bell-ha/fog-cue/1_아이디어발표/parts/buzzer_active.png

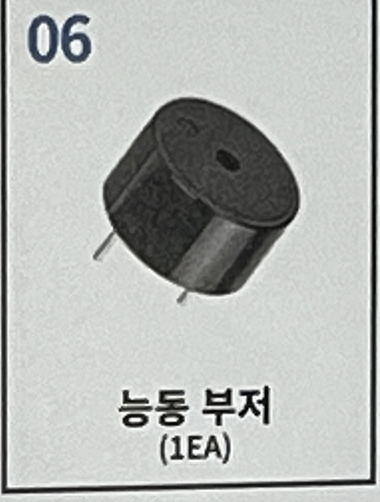
1_아이디어발표/parts/buzzer_active.png
