bell-ha/fog-cue/_발표자료_보관/parts/pulse.png

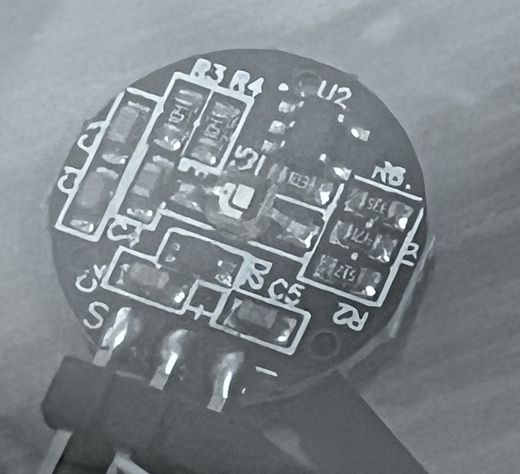
_발표자료_보관/parts/pulse.png
