bell-ha/fog-cue/2_중간발표/32203482이종하_개인맞춤형디바이스개발_중간발표.pptx

## 보행동결 자극 시스템

중간발표

IMU 기반 보행 동결 검출 및 청각 자극 시스템

32203482 이종하

## 목차

중간발표

01

프로젝트 개요

시스템 구성

05

동결 판정

설계 변경 사항

02

06

데이터 수집

03

향후 계획

07

보행 신호 분석

04

## 프로젝트 개요

문제 파킨슨 환자는 걷다가 갑자기 발이 바닥에 붙는 현상이 일어난다 (보행 동결)

걸음 측정

허리에 찬 가속도 센서

1

동결 감지

발이 안 떨어지는 순간

2

메트로놈 재생

직전 걸음 빠르기에 맞춤

3

고려할 점

계속 울리면 귀가 익숙해져 반응이 줄어듦, 그래서 동결일 때만 울림

다시 걸으면 소리 멈춤

## 시스템 구성(회로 연결)

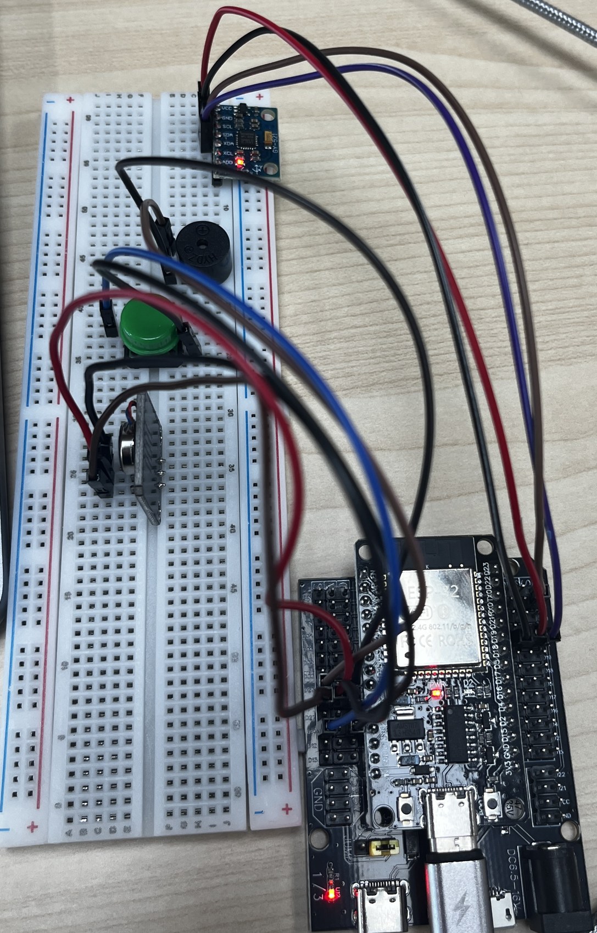
[picture p3: figure]
브레드보드와 ESP32 확장보드 실물
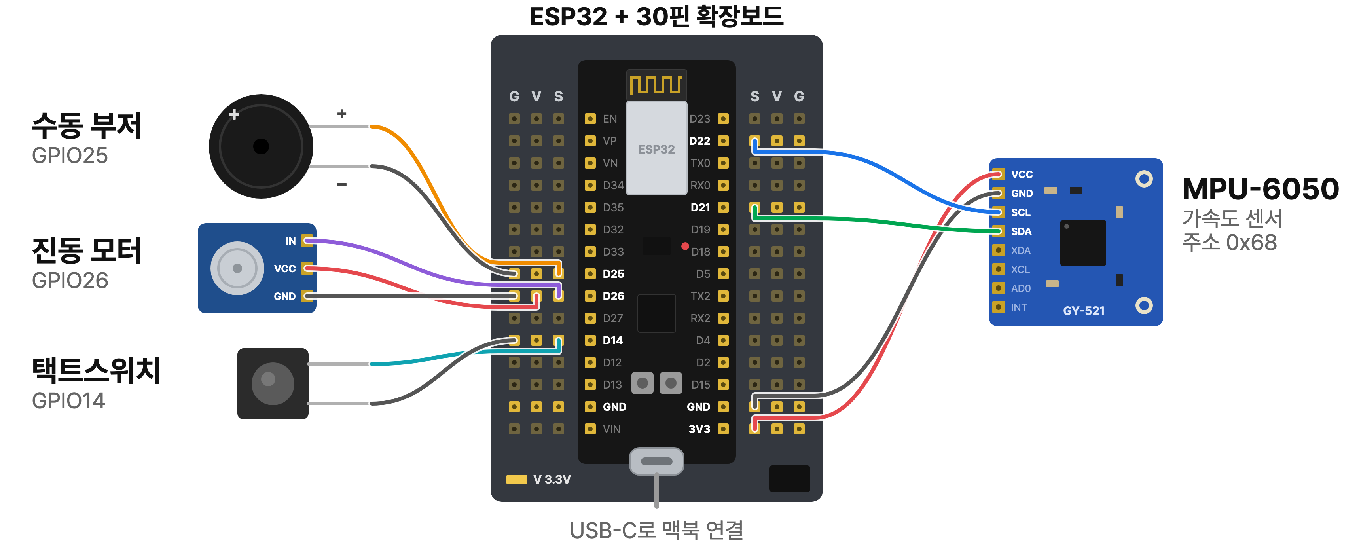
[picture p4: figure]
ESP32 확장보드와 MPU-6050, 수동 부저, 진동 모터, 택트스위치 연결도

## 시스템 구성(기능 테스트)

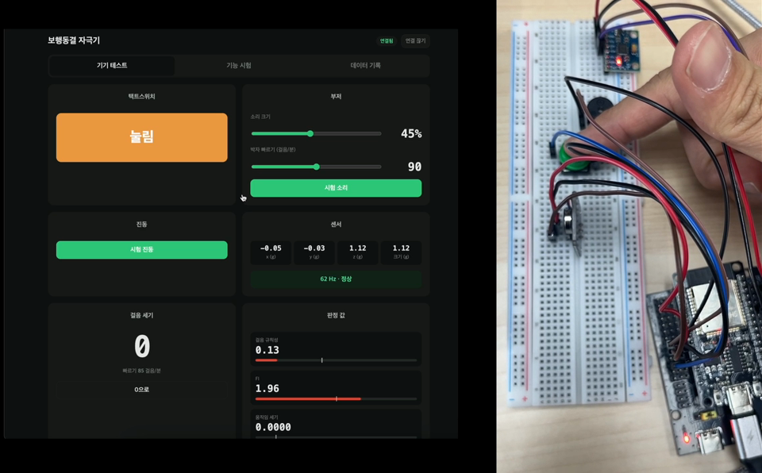
[picture p5: figure]
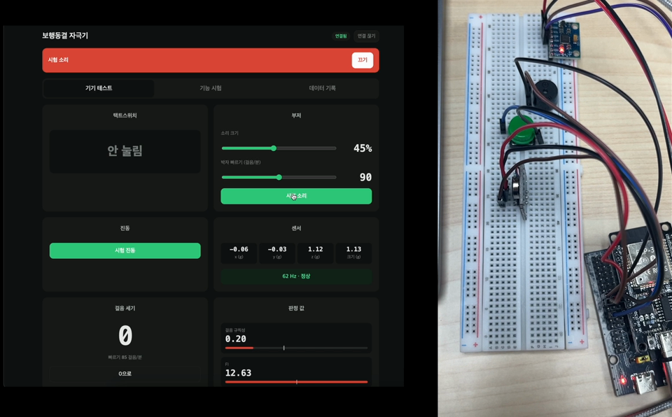
[picture p6: figure]

버튼

진동

부저

걸음

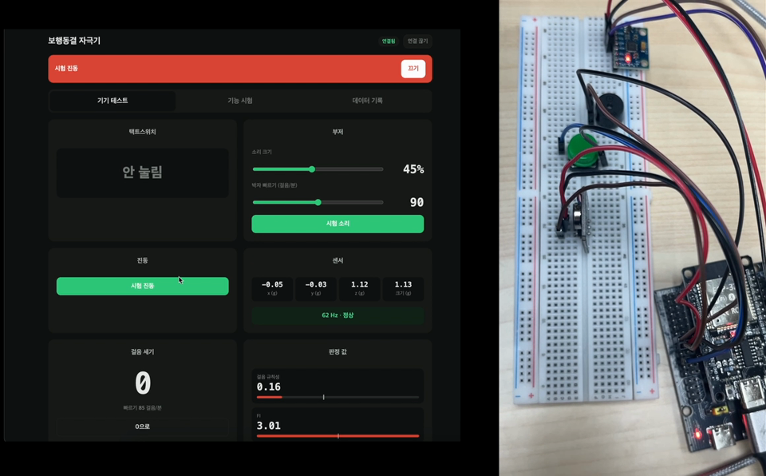
[picture p7: figure]
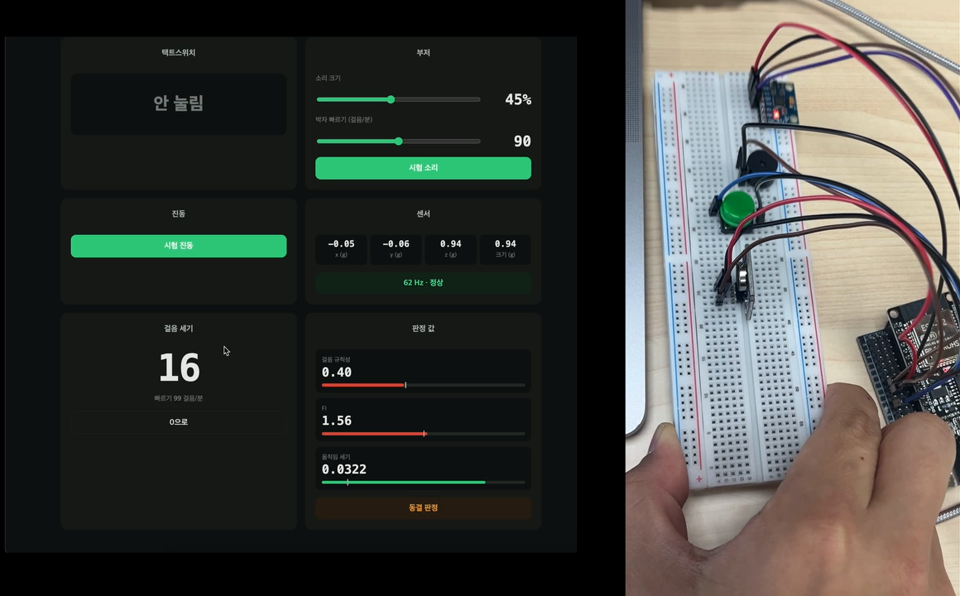
[picture p8: figure]

## 시스템 구성(착용과 기록 환경 가정)

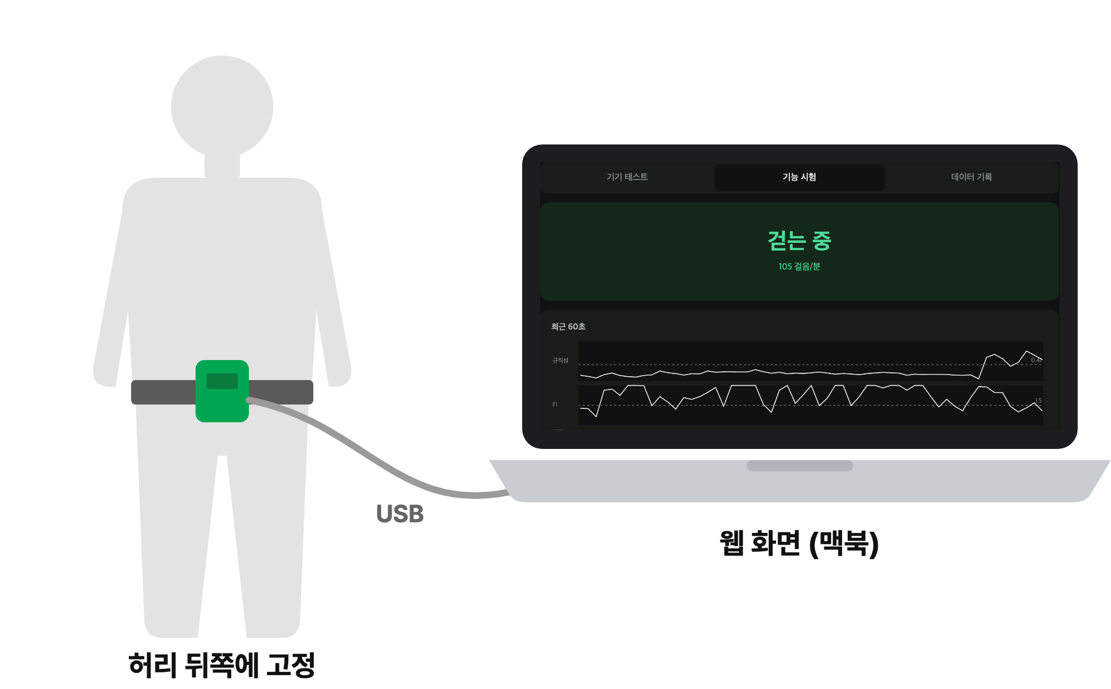
[picture p9: figure]
허리 뒤쪽에 고정한 기기와 USB로 연결한 맥북 기록 화면

62.0~62.4 Hz

샘플레이트 (설계값 62.5 Hz)

32 / 32

걸음 세기

Notes: 센서 값을 1초에 62번 읽음.(DAPHNet 파킨슨 환자 데이터의 측정 속도)

32걸음 걸었을 때 32걸음을 세었다.(환자 데이터도 그렇게 구성)

## 데이터 수집

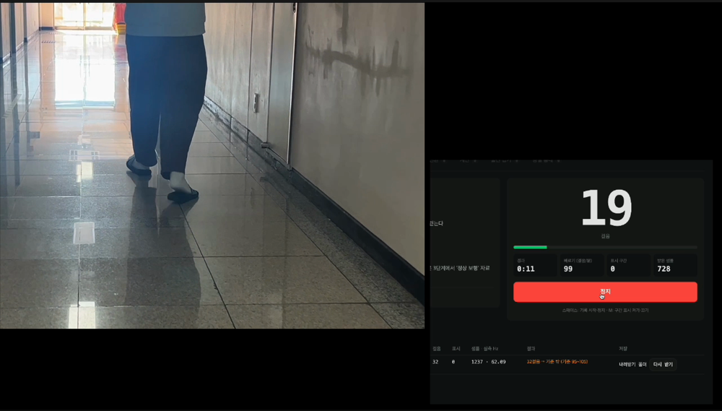
[picture p10: figure]

걷기

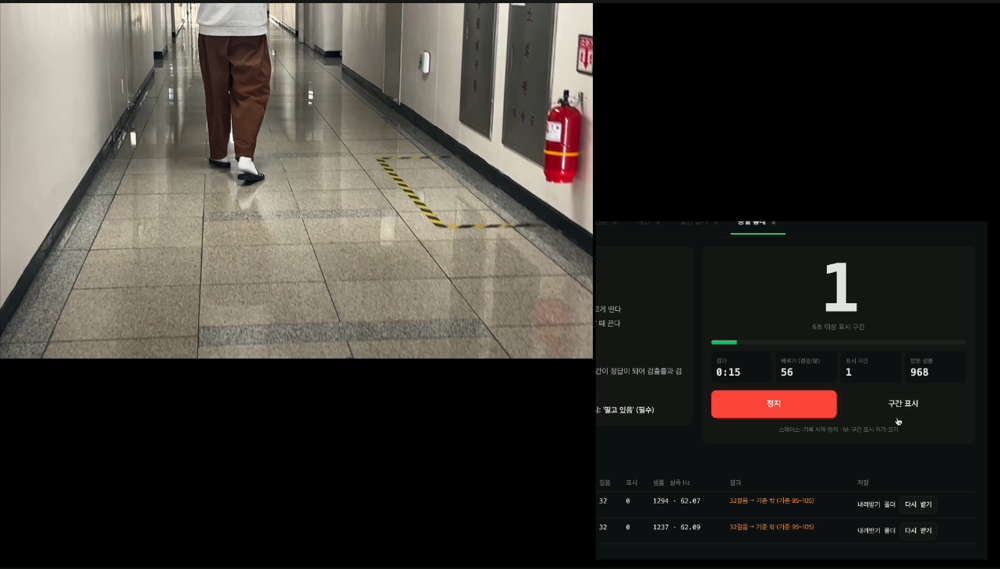
[picture p11: figure]

동결 재현

## 보행 신호 분석

흔들림 크기: 걷기 0.14~0.21 g, 동결 재현 0.08~0.24 g

흔들림 크기 (g)

걷기

걸음 규칙성: 걷기 0.43~0.68, 동결 재현 0.09~0.37

걸음 규칙성
4초동안 같은 모양의 걸음이 반복되는 정도 (0~1)

0.14~0.21

동결 재현

0.08~0.24

0

0.1

0.2

0.3

걸음 규칙성 (0~1)

걷기

기준 0.41

3~8 Hz 떨림(FI)

0.43~0.68

동결 재현

서 있는 동안에도 걸음이 세어짐

0.09~0.37

0

0.5

1

Notes: g(가속도 단위): 중력을 1g라 보고, 흔들림 0.14g는 중력의 14%정도 흔들렸다.
Hz: 1초에 몇 번 흔들렸는지
걸음 규칙성: 4초 안에서 같은 모양의 흔들림이 되풀이 되는 정도. 1에 가까울 수록 고르게 걷는 거
FI(Freeze Index,동결지수): 떨림의 세기(3~8Hz)를 걸음 리듬의 세기로 나눈 비율. 1.5이상 떨림이면 걸음 리듬보다 1.5배 세다는 뜻 -> 동결로 판정
1초에 3~8번 떨린다는 연구를 토대로

## 동결 판정(테스트)

움직임 세기 ≥ 0.005

AND

걸음 규칙성 < 0.41

OR

FI ≥ 1.5

2회 연속이면 작동

FI를 같이 보는 이유: 일정한 박자로 떨면 규칙성이 높게 나옴 + 선행 연구의 벤치마킹

판정 방식 | 잡힌 동결 재현 | 판정까지 | 걷기 중 오작동
FI만 (아이디어 발표) | 4 / 7 | 4.6초 | 0회
규칙성 + FI (현재) | 7 / 7 | 3.0초 | 0회

Notes: g(가속도 단위): 중력을 1g라 보고, 흔들림 0.14g는 중력의 14%정도 흔들렸다.
Hz: 1초에 몇 번 흔들렸는지
걸음 규칙성: 4초 안에서 같은 모양의 흔들림이 되풀이 되는 정도. 1에 가까울 수록 고르게 걷는 거
FI(Freeze Index,동결지수): 떨림의 세기(3~8Hz)를 걸음 리듬의 세기로 나눈 비율. 1.5이상 떨림이면 걸음 리듬보다 1.5배 세다는 뜻 -> 동결로 판정
1초에 3~8번 떨린다는 연구를 토대로

## 동결 판정(실시간 구현)

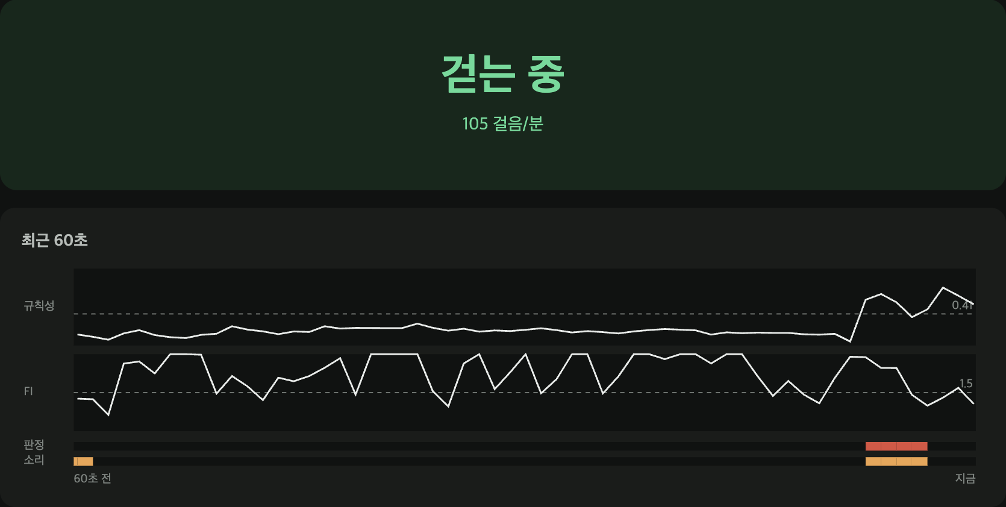
[picture p12: figure]
걷는 중
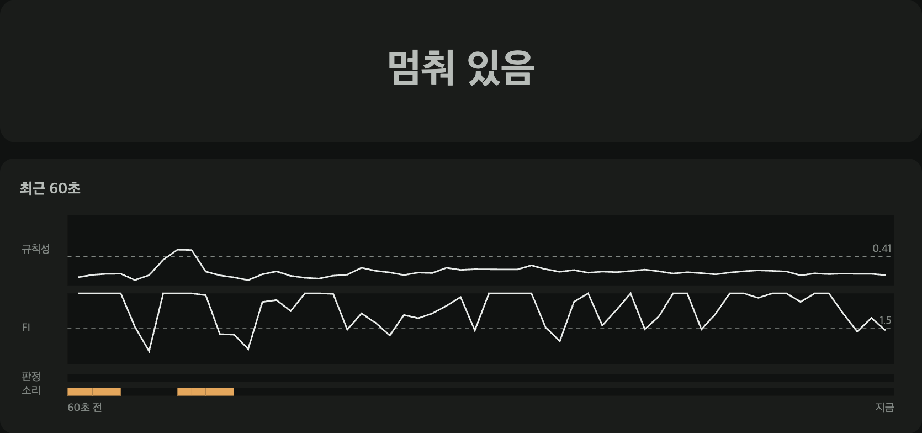
[picture p13: figure]
멈춰 있음
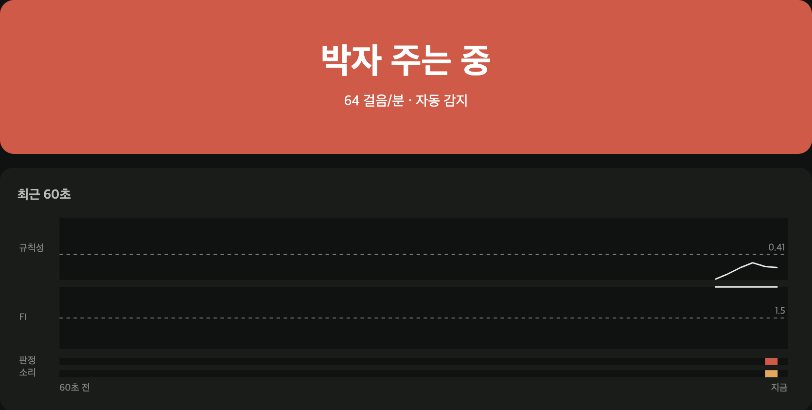
[picture p14: figure]
박자 주는 중

## 설계 변경 사항

항목 | 아이디어 발표 | 현재 | 비고
판정 기준 | FI만 | 규칙성 + FI + 움직임 세기 | FI로 잡히지 않는 경우 존재
판정 시점 | 발이 멈춘 뒤 | 걸음과 무관하게 계속 | 떠는 동안에도 걸음이 세어져 멈춤이 감지 안 됨
템포 | 직전 케이던스 | 5초 전 케이던스 | 판정 무렵엔 떨림이 걸음으로 세어져 케이던스가 높게 나옴 (95~137, 평소 85~90)
끄는 시점 | 다시 걸을 때 | 판정이 2회 연속 풀릴 때 | 떨림이 멈춘 뒤 2~3초 더 울림
텍트스위치 | 부가기능 | 필수기능 | 동결 감지 오작동으로 인해

## 향후 계획

선택 기능

낙상 감지

큰 충격 뒤 누운 자세가 이어지면 낙상으로 판단

필수 기능

오작동 감소

반복 테스트

보호자 알림

낙상 감지하면 보호자 휴대폰으로 알림

실시간 판정 검증

걷기, 섰다가 걷기, 동결 재현을 시험

방향 전환 구분

오작동 감소를 위해 회전방향을 측정

무선 연동

무선으로 연결해 휴대폰에서 상태 확인

심박 측정 추가

확장 기능

Notes: [사용자 중심적 피드백]

보행, 낙상감지를 시나리오를 쓰면 구체화가 된다.
생각하고 있는 시나리오에 알맞게 모바일 기능, 어떤 기능 등등을 추가하면 좋겠다.
페르소나랑 시나리오를 통해 구현(구체적으로)
시나리오를 조금 더 풍성하게,
페르소나도 하나가 아니라, 여러가지도 있을 수 있다.
구현하는데 어떤 것을 생각할 지 고려하면 좋을듯.
사용자 중심 설계(가상의 인물을 그려서)

[공학적인 피드백]

주된 기능에 대한 포커스가 있으면 좋을듯
하나 프로젝트에 대한 욕심이 많은 것 같음.
그 기능이 강조되지 못한 것 같다. 연구적인 것보다 프로젝트 제품에 대한 것을 더 중점적으로.
페르소나를 봐야
