bell-ha/fog-cue/_발표자료_보관/README.md

# 보행동결 자극 시스템 — 중간과제

**IMU 기반 보행 동결 검출 및 케이던스 적응형 청각 자극 시스템**
개인맞춤형 디바이스 개발 · 32203482 이종하 · 제출 2026.09.27

> 파킨슨 환자는 걷다가 갑자기 발이 바닥에 붙습니다.
> 그 순간을 감지해 박자를 들려주는 허리 벨트입니다.

---

## 📌 제출본

**`32203482이종하_개인맞춤형디바이스개발_중간과제.pptx`** — 11장. **이게 최종입니다.**

```
 1  보행동결 자극 시스템                     표지
 2  파킨슨 환자는 걷다가 갑자기 발이 바닥에 붙는다   〈주제〉
 3  누가 쓰는가                            〈대상〉〈페르소나〉
 4  박자를 들려주면 굳은 다리가 풀린다           〈주제 선정 이유〉
 5  계속 울리면 익숙해져서 안 듣게 된다
 6  발이 안 떨어질 때만 울린다
 7  떨림 주파수로 보행 동결(FoG)을 검출한다
 8  수업에 활용된 기능                       〈수업에 활용된 기능〉
 9  4단계로 계획
10  한계는 다음과 같다
11  걷다 멈춘 순간에만 울리는 자극              결론
```
과제 필수 5항목이 모두 들어 있습니다.

### 발표 전 확인
- **5 → 6번 전환에 모핑(Morph)** — 두 장은 축과 동결 마커 좌표가 같습니다. 모핑을 걸면 **틱 울타리가 사라지고 버스트 3개만 남습니다.** 이 덱에서 가장 강한 장면입니다
- **Pretendard · IBM Plex Mono** 설치 여부. 없으면 대체 폰트로 떠서 글자 폭이 달라집니다
- **PDF도 함께 제출** — Mac PowerPoint는 폰트 임베딩이 안 됩니다

### 아직 비어 있는 것
**국내 파킨슨 환자 수.** [심평원 opendata.hira.or.kr](https://opendata.hira.or.kr) → 국민관심질병통계 → 파킨슨병.
조회한 값과 조회일을 적으면 어떤 재인용보다 강합니다. 2번 슬라이드에 넣을 자리가 있습니다.

---

## 📁 폴더

| | 내용 |
|---|---|
| `HARDWARE.md` | **하드웨어 구현 상세** — 결선·핀 배치·신호처리·전력·개발 순서 |
| `DATA.md` | 검증된 수치와 출처 · 폐기한 수치 목록 |
| `parts/` | 실물 부품 사진 8장 (8번 슬라이드에 사용) |
| `_source/` | SVG 원본 13장 + 제작 도구 · 규격서 |
| `_build/` | 렌더 이미지 · pptx용 배경판 |
| `_reference/` | TeamCAST 발표자료 (디자인 참고용) |
| `_archive/` | 폐기된 규격서 · 백업 |

### ⚠️ `_source/`의 SVG는 제출본과 다릅니다
SVG는 **13장**이고 제출본은 **11장**입니다. 제출본을 만들면서 세부 구현 두 장(하드웨어 구성 · 신호처리 설계)을 빼고 제목 여럿을 고치셨습니다.
**수정은 pptx에서 직접 하세요.** SVG로 pptx를 다시 생성하면 그 편집이 전부 사라집니다.

SVG에만 있고 제출본에 없는 내용:
- `핀 배치는 제약이 정한다` — WiFi를 켜면 ADC2를 못 쓴다 · I2C 버스 공유 · 핀 배치표
- `값은 감으로 정하지 않았다` — 64 Hz · 256샘플 4초 · 2회 연속 판정 · 상태 전이도

두 장의 내용은 **`HARDWARE.md`에 전부 남아 있습니다.** 질문이 나오면 거기서 답하면 됩니다.

---

## 💬 예상 질문과 답

| 질문 | 답 |
|---|---|
| 보행 속도와 케이던스 차이는 | **보행 속도 = 보폭 × 케이던스.** RAS는 케이던스를 올리지 못하고 보폭을 늘려 속도를 올립니다. 같은 박자에서 더 크게 내딛는 겁니다 |
| 이미 있는 거 아닌가 | ParCuR(Sensors 2025)이 유사합니다. **4번에서 우리가 먼저 꺼냅니다.** 우리가 더하는 건 청각 자극과 케이던스 적응입니다 |
| 왜 256샘플인가 | 64 Hz에서 정확히 4초입니다. Freeze Index 원 정의와 같은 길이입니다 |
| 261 ms 가능한가 | 아닙니다. 우리 구조는 **약 2초**입니다. 7번에 그렇게 적혀 있습니다 |
| 환자 데이터는 | DAPHNet (UCI, **CC BY 4.0**). 몸통 채널만 씁니다 |
| 그 환자 만나봤나 | 페르소나는 근거가 아니라 **근거를 사람 말로 옮긴 것**입니다. 근거는 5번입니다 |
| 왜 이 주제인가 | *(구두로)* 리듬 자극은 음악치료 기법이고, 템포를 다루는 건 제 전공 영역과 겹칩니다 |

> ### ⚠️ 위 표의 두 줄은 이후 구현 과정에서 틀린 것으로 확인됐습니다 (2026-10-14)
>
> **발표 당시의 기록이므로 위 표는 고치지 않았습니다.** 다만 최종 보고서나 추가 질의응답에
> 그대로 재활용하면 틀린 답이 됩니다. 재활용할 때는 아래로 바꾸세요.
>
> | 질문 | 발표 때 준비한 답 | **맞는 답** |
> |---|---|---|
> | 261 ms 가능한가 | 약 2초입니다 | **3~4초입니다** (hold=2에서 중앙값 3.8초) |
> | 왜 256샘플인가 | Freeze Index 원 정의와 같은 길이 | **Bächlin 2010(DAPHNet 논문)이 고른 길이**입니다 |
>
> · **지연** — '약 2초'는 유지 조건(연속 2회)만 센 숫자였고, **4초짜리 창이 채워지는 시간**을
>   빼먹었습니다. 창이 동결 구간에 충분히 들어가야 FI가 넘습니다.
>   동결 시작 위상을 16번 옮겨가며 측정한 값: `hold=1 → 2.8초 / hold=2 → 3.8초 / hold=3 → 4.8초`
> · **256샘플** — Moore 2008 원 논문의 윈도우 길이는 확인하지 못했습니다.
>   '원 정의와 같다'고 말할 근거가 없으므로 Bächlin 2010에 귀속합니다.
>
> 근거와 재현 방법: `구현/docs/HARDWARE.md` 3절, `구현/analysis/freeze_index.py :: latency()`

## 🎤 발표 노트

- **첫 멘트** — `걷다가 발이 굳는 순간에만 박자를 들려주는 벨트입니다` (11번 결론에도 같은 문장)
- **8번 하단** `왜 ESP32 / 왜 허리 / 왜 수동 부저`는 읽지 말고 질문 대비용으로
- **10번에서 한계를 먼저 말하세요.** 알고도 넘어가지 않았다는 게 이 발표의 강점입니다
- 실측 발표 시간 약 15분 (13장 기준). 11장이면 더 짧습니다
