bell-ha/fog-cue/구현/docs/README.md

# 참고 문서

| | 내용 |
|---|---|
| `HARDWARE.md` | 핀 배치 · 센서 설정 · 신호처리 · 전력 예산 · 예상되는 문제 |
| `DATA.md` | 검증된 수치와 출처 · **폐기한 수치 목록** |
| `CURRICULUM.md` | 14주 구현 커리큘럼 (작성 중) |

`DATA.md`의 폐기 목록을 먼저 보세요. 검색 요약만 보고 받아적었다가
원문 대조에서 틀린 것으로 드러난 수치들입니다. 같은 실수를 반복하지 않으려고 남겨뒀습니다.
