bell-ha/fog-cue/구현/docs/DATA.md

# 조사 자료 — 슬라이드에 넣을 수치와 근거
출처 URL을 슬라이드 하단에 작게 병기할 것. 수치는 반올림해서 쓰되 원값을 함께 남겨둠.

## 1. 국내 파킨슨병 환자 규모 — 02번  ⛔ 검증 실패 · 사용 금지
**제가 처음 적은 `120,547명 / 5년간 14% 증가`는 출처 원문에 없는 숫자였습니다.** 재인용 과정에서 연도와 값이 섞인 것으로 확인됐습니다. 원문이 실제로 말하는 것은 다릅니다.
- 118,504명 **(2021)** — 심평원 기준, 위 URL 원문에 실제로 적힌 값
- 142,013명 (2023) — 다른 기사
- 약 149,000명 (2023) — 심평원 국민관심질병통계 인용 블로그
- `60대 이상 92.7%`는 심평원 2023 연령 분포와 부합하나 출처가 개인 블로그
- 파킨슨병(G20)만인지 파킨슨증(G20~G22) 포함인지도 확정 못 함

### → 슬라이드 처리 (둘 중 하나)
**(a) 숫자 없이 서술** — `국내 파킨슨병 환자는 매년 늘고 있고, 대부분이 60대 이상이다.`
**(b) 사용자가 직접 조회 ★ 권장** — 심평원 보건의료빅데이터개방시스템 `국민관심질병통계`
   https://opendata.hira.or.kr → 파킨슨병 조회 → 연도별 환자 수
   **본인이 조회한 값과 조회일을 적는 것이 어떤 재인용보다 강합니다. 5분이면 됩니다.**

## 2. 보행 동결 유병률 — 02번  ✅ 원문 대조 완료
Ge H-L 외, *The prevalence of freezing of gait in Parkinson's disease and in patients with different disease durations and severities*, **Chinese Neurosurgical Journal, 2020** (PMC7398304)
- **메타분석 29편 · 총 5,361명**
- 전체 유병률 **39.9%** (95% CI 35.3–44.5%)
- 이환 기간별 (원문 수치 그대로, CI 포함)
  - 5년 미만 **22.4%** (95% CI 12.8–31.9)
  - 5년 이상 **53.3%** (95% CI 45.8–60.8)
  - 10년 이상 **70.8%** (95% CI 60.8–80.9)
⚠️ **누적 구간입니다.** `≥5년`과 `≥10년`이 겹치므로 세 값을 나란히 놓고 배타적 구간처럼 비교하면 오독입니다.
→ **"5년 미만 22.4%에서 10년 이상 70.8%로 증가"** 라는 증가 서술로 쓰는 건 정확합니다.
**슬라이드 문구**: `파킨슨병 환자의 39.9%가 보행 동결을 겪는다 (Ge et al., 2020, 메타분석 29편·5,361명)`
출처: https://cnjournal.biomedcentral.com/articles/10.1186/s41016-020-00197-y

## 3. 낙상과의 연관 — 02번  ⚠️ 수치는 맞으나 서술 오류. 사용 비권장
실제 구조: 401명 1년 추적 → 그중 **44명(11%)이 반복 낙상** → 그 **44명 중 21명(48%)** 이 보행 동결 보유.
→ 제가 적은 `반복 낙상 환자의 48% (401명 추적)` 은 **48%의 분모가 401인 것처럼 읽힙니다.** 실제 분모는 44명이고, 21/44는 표본이 작아 발표에서 공격받기 쉽습니다.
**권고: 쓰지 않는 편이 낫습니다.** 꼭 쓴다면 분모를 드러낼 것 —
`1년간 반복 낙상을 겪은 44명 중 21명(48%)이 보행 동결을 갖고 있었다 (401명 추적 코호트)`
출처: https://www.sciencedirect.com/science/article/abs/pii/S135380201730384X

## 4. 리듬 청각 자극(RAS)의 효과 — 03번
- 메타분석(18개 연구, 774명): **보행 속도 0.53 SD, 보폭 0.51 SD 개선** (대조군 대비)
- 근거 수준: 보행 속도·균형은 중간 확실성
- ⚠️ **정직하게 반영할 것** — **케이던스(분당 걸음 수)에 대한 효과는 메타분석마다 엇갈리고 통계적으로 유의하지 않은 결과도 있음.**
  → 슬라이드에서 RAS의 효과를 **"보행 속도와 보폭이 개선된다"** 로 쓰고, "박자 수가 늘어난다"고 쓰지 말 것. 우리 기기는 케이던스를 **측정해서 템포를 맞추는** 것이지 케이던스를 올리는 게 목적이 아님.
출처: https://pubmed.ncbi.nlm.nih.gov/34121062/ , https://www.nature.com/articles/s41598-017-16232-5

## 5. ★ 상시 큐잉 vs 개입형 큐잉 — 04·05번 (지금까지 비어 있던 핵심 근거)
이게 이 발표 논리의 중심축인데 근거가 없었습니다. 확보했습니다.
- **상시 큐잉의 부작용 — 원문에서 확인된 것은 2가지뿐입니다**
  - 장기 사용 시 **습관화(habituation)** ✅ 원문 확인
  - **인지 부하 증가** ✅ 원문 확인
  - ~~큐 의존성(cue dependency)~~ ⛔ **이 논문에서 확인 안 됨. 슬라이드에서 삭제**
  - ~~피로 악화~~ ⛔ **확인 안 됨. 삭제**
  원문: "continuous cueing though shown effective in some cases, can lead to habituation over prolonged use and can increase one's cognitive load"
  출처: Pallavi 외, *On-Demand Cueing Sensitive to Step Variability*, IEEE J Transl Eng Health Med, 2025 (PMC12251033)
  ⚠️ **이 논문은 동결 시작 *전에*(predictive) 개입하자는 노선입니다.** 우리는 "시작 직후 검출"이라 노선이 다릅니다. **04번의 근거로만 쓰고 05번 근거로 인용하지 말 것.**
- → 그래서 **"필요할 때만 주는(on-demand) 큐"의 필요성이 제기됨**
- 개입형 웨어러블 실측 — ✅ 네 수치 전부 원문 확인
  실시간 40 Hz 처리 / **검출 지연 261 ms** / **검출 정확도 95.1%** / **동결 지속 시간 평균 45% 감소**
  Slemenšek 외, *Wearable Online Freezing of Gait Detection and Cueing System*, **Bioengineering (Basel), 2024** (PMC11505507)
  ⚠️ **총 표본 9명** (오프라인 검출 6명 + 실시간 3명). **45% 감소는 3명에서 나온 값입니다.**
  → 09번 목표 벤치마크로는 적절하나 **"이미 입증된 기술"처럼 단정 금지.**
  **슬라이드 문구**: `선행 연구에서 261 ms 검출·정확도 95.1%가 보고됐다 (Slemenšek et al., 2024, n=9 예비연구)`
  `n=9`를 적는 것이 오히려 한계를 안다는 신호가 됩니다.

## 6. 기존 제품·연구 — 04번
상용/연구 단계에서 이미 존재하는 것들 (04번 "기존 제품도 상시 큐다"의 근거)
- 레이저 큐 신발·지팡이 (시각 큐)
- 웨어러블 진동 큐잉 기기
- 스마트폰 메트로놈 앱
- 연구용: Holocue(홀로그램 큐), ParCuR(AI 큐잉 웨어러블)
→ 대부분 **상시 재생이거나 사용자가 직접 켜고 끄는 방식**. 자동 개입은 아직 연구 단계.

## 표기 규칙
- 슬라이드에 수치를 쓸 때는 **연도와 출처 기관**을 함께: `약 12만 명 (2023, 건강보험 진료 기준)`
- 하단에 mono 14px 회색으로 출처 URL 축약 표기: `출처 — 심평원 / Chinese Neurosurgical Journal 2020 / ...`
- 없는 숫자를 만들지 말 것. 위에 없는 수치는 슬라이드에 쓰지 않습니다.

---
# 2차 검증 결과 (12 담당) — 확정본
아래가 최종입니다. 위 4·6절 중 충돌하는 내용은 아래를 따릅니다.

## 4′. RAS 효과 — ⚠️ 서로 다른 논문이 합쳐져 있었음
**두 수치는 다른 논문입니다. 함께 쓰지 마세요.**
- `보행 속도 0.53 SD (95% CI 0.23–0.83, P=.0005) / 보폭 0.51 SD (95% CI 0.18–0.84, P=.003)`
  = **Arch Phys Med Rehabil 2021, 메타분석 5편 · 209명**
- `보폭 WMD 4.64 cm / 속도 WMD 0.06 m/s (p<0.001)`
  = **Frontiers in Neurology 2022, 메타분석 18편 · 774명** (완전히 다른 논문)
- ⛔ **`근거 수준 중간 확실성` 삭제.** 원문은 `The quality of evidence was low` 이고 비뚤림 위험도 명시됨(맹검 부재)
**슬라이드 문구(03)**: `메타분석 5편 209명 — 보행 속도 0.53 SD, 보폭 0.51 SD 개선 (Arch Phys Med Rehabil 2021, 근거 수준 낮음)`

## 4″. 케이던스 비유의 — ✅ 출처 특정 완료
Frontiers in Neurology 2022 원문: `pooled WMD 1.57 (95% CI −4.91–8.05, P = 0.635), suggesting that the effect of RAS on step frequency was not significant.`
**슬라이드 문구(03·06)**: `RAS는 보행 속도와 보폭을 개선한다. 케이던스에는 유의한 효과가 없다 (WMD 1.57, P=0.635). 그래서 이 기기는 케이던스를 올리는 것이 아니라, 직전 케이던스를 측정해 템포를 맞춘다.`
→ 이 근거가 우리 설계를 **약화시키는 게 아니라 강화**합니다. "케이던스를 올리려는 게 아니다"라고 먼저 말할 수 있습니다.

## 5′. 상시 큐잉 부작용 — 2개만 사용
✅ 습관화 / ✅ 인지 부하 증가 — 원문 확인
⛔ 큐 의존성(언급 자체 없음) / ⛔ 피로 악화(독립 항목 아님) — **삭제**
※ 근거 없이 네 개를 나열하면 교수가 하나만 짚어도 나머지 셋의 신뢰가 같이 무너집니다. **두 개가 더 강합니다.**
**추가 실측치 (IEEE JTEHM 2025)** — 보폭 변동성 no-cue 대비 on-demand **49.25% 감소** / 보행 속도 continuous 대비 **8.37% 증가** / ★ **큐가 실제 전달된 시간은 전체 보행의 21~29%**
→ 마지막 값이 **05번 "20분 중 세 번뿐"의 실증 근거**입니다. 이쪽이 훨씬 강합니다.

## 6′. 웨어러블 벤치마크 — ✅ 전부 같은 연구. 단 조건 필수
Bioengineering (Basel) 2024. 40 Hz / 261 ms / 95.1% / 45% 모두 자체 결과.
- 전체 9명(오프라인 6 + 실시간 3). **45%는 실시간 3명 기준** (개별 32 / 44 / 58%), 자기 자신 대조
- ★★ **이 시스템의 큐는 진동(vibratory)입니다. 소리가 아닙니다.**
**슬라이드 문구(06)**: `진동 큐 기반 웨어러블 실측 — 검출 지연 261 ms, 검출 정확도 95.1%, 동결 지속 시간 45% 감소 (3명 기준, Bioengineering 2024). 검출 성능은 이 범위를 목표로 한다.`
→ **"검출 성능"으로 한정**해야 "자극 양식이 다른데 같은 성능을 기대하는 근거는?"을 피합니다.

## 7. ★★★ 기존 제품 — 차별점 주장 전면 교체
`기존 제품도 대부분 상시 큐이거나 수동 온/오프다` 는 **사실이 아닙니다. 삭제.**

| 제품/연구 | 단계 | 작동 방식 |
|---|---|---|
| **Path Finder** (Walk With Path) | **상용** Class 1 | **자동** — 발 압력으로 레이저 발화. 단 *걸음마다* 발화 (19명, 동결 46% 감소) |
| **Holocue** (HoloLens) | 연구 | on-demand 시각 큐. **24명, FOG에 즉각 효과 없음** |
| **ParCuR** | 연구 (Sensors 2025) | ★ **동결 자동 검출 → 자동 햅틱 큐.** 발목 35×41mm, 0.7초 내 발화, 민감도 94.9%·특이도 91.3%, **DAPHNet으로 학습** |
| 메트로놈 앱 | 상용 | 상시/수동 |

★★ **ParCuR은 우리 컨셉과 거의 같습니다.** 우리가 쓰려던 DAPHNet 데이터셋까지 같습니다. `자동 개입형은 없다`는 주장은 성립하지 않습니다.

### 교체된 차별점 (04·10번)
1. **상용 제품은 동결을 검출하지 않는다.** Path Finder는 걸음마다, 앱은 계속 울린다 — 둘 다 "동결일 때만"이 아니다
2. **동결을 검출해 개입하는 것은 연구 단계에 있고, 대부분 진동 큐다** (ParCuR, Bioengineering 2024)
3. **우리 자리** — 동결 검출 + **청각** 큐 + **직전 케이던스에 맞춘 템포**. 세 번째는 위 연구 어디에도 없다
4. **학부 과제로서의 정직한 포지션** — `연구 단계에서 실증된 접근을 학습용 KIT로 재현한다`
→ 교수가 "이미 있는 거 아니냐"고 물으면 **ParCuR을 먼저 꺼내는 쪽이 이깁니다.** 몰라서 안 넣은 것과 알고 자리를 잡은 것은 다르게 평가됩니다.

## 8. 그래픽 원칙 — 전 장 적용
같은 종류의 양(파워·비율·시간)을 두 구간으로 가를 때는 **색상(hue)이 아니라 한 hue의 명도 2단계**로 가릅니다. 색상으로 가르면 "다른 종류"로 보이고, 명도로 갈라야 **"같은 것의 양이 이동했다"** 가 읽힙니다.

## 9. 폐기 목록
- `18개 연구 774명` + `0.53/0.51 SD` 병기 → 분리
- `근거 수준 중간 확실성` → 삭제 (원문 low)
- `큐 의존성`, `피로 악화` → 삭제
- `기존 제품도 대부분 상시 큐` → 삭제, 7절로 교체
- 동결 발생 감소 `WMD −2.06` → CI가 0을 걸치는데 p<0.05라 표기 불일치. **사용 금지**

---
## 10. ✅ DAPHNet 데이터셋 — 접근 가능 확인 (2026-09-16 조회)
10번 카드 03의 대응책 근거. **실제로 받을 수 있고 라이선스도 문제없습니다.**
- **UCI Machine Learning Repository** — https://doi.org/10.24432/C56K78
- **라이선스 CC BY 4.0** — 출처 표기만 하면 사용·변형 자유. 학부 과제 제약 없음
- CSV 형식. pandas/numpy로 직접 로드 가능
- 파킨슨 환자의 **엉덩이(hip)·다리 3개 가속도 센서** 측정값 + 동결 구간 라벨
- ★ **허리 착용 설계와 맞음** — hip 채널이 포함돼 있어 해당 채널만 추출해 검증 가능
슬라이드 문구 예: `동결 구간이 라벨링된 공개 데이터(DAPHNet, UCI, CC BY 4.0)로 검증한다. 허리 채널만 추출해 쓴다.`
