bell-ha/fog-cue/_발표자료_보관/_archive/SPEC.md

# 아타카 (Attacca) — 발표 SVG 제작 규격서
11장. 각 장을 독립 SVG 파일로. 파일명 `01.svg` ~ `11.svg`, 이 디렉터리에 저장.

## 0. 절대 규칙
- 캔버스 **1600 × 900** (16:9). `<svg xmlns="http://www.w3.org/2000/svg" viewBox="0 0 1600 900" width="1600" height="900">`
- **외부 리소스 금지**: 웹폰트 link, 외부 이미지, `<foreignObject>` 전부 금지. 파일 하나로 완결.
- 텍스트는 반드시 `<text>` 엘리먼트. path로 변환하지 말 것 (PowerPoint에서 수정 가능해야 함).
- 모든 색은 아래 토큰 값을 리터럴 hex로 직접 기입.
- 첫 줄에 `<!-- 01 표지 -->` 형태 주석으로 슬라이드 번호와 제목 표기.

## 1. 색 규율 — 이 덱의 핵심
발표 논지가 "반복되면 안 듣게 된다"이므로 **덱 자체가 습관화되면 안 됨.**

- **강조색(오커)은 본문에서 05 · 08 · 11번에만 등장.** 나머지 8장은 완전 무채색.
- 04번을 넘기는 순간 화면에 처음 색이 등장 → 클라이맥스 장치. 04번 틱에 절대 색 쓰지 말 것.
- **침묵은 칠하지 말고 비운다.** 회색 박스로 침묵 구간을 칠하면 침묵이 아니게 됨.
- **동결·낙상에 빨강 금지.** 위험은 형태와 여백으로 표현.
- 예외: 하단 진행 틱의 활성 틱 1개는 **모든 장에서** 오커. (메트로놈 모티프)

### 밝은 장 (01·02·03·06·07·08·09·10·11)
```
bg      #F4F2ED   배경 (전면 rect)
ink     #14181C   제목·실루엣
ink2    #5A636B   본문
ink3    #8A9098   캡션·라벨·비활성
line    #DCD8D0   괘선·축
accent  #A87218   오커 (05·08·11 본문 + 전 장 활성틱)
soft    #EDE4D2   오커 연한 (극히 제한적)
```
### 어두운 장 (04·05만)
```
bg      #0E1216
ink     #C9D1D9
ink2    #97A1AB
ink3    #5E6873
line    #2A333C
accent  #E3A83C
```

## 2. 타이포그래피
폰트가 없는 환경을 대비해 **반드시 스택으로** 기입.
```
제목  font-family="Hahmlet, 'Nanum Myeongjo', 'Apple SD Gothic Neo', serif"  font-weight="600"
본문  font-family="Pretendard, 'Apple SD Gothic Neo', 'Malgun Gothic', sans-serif"
숫자  font-family="'IBM Plex Mono', 'D2Coding', Menlo, monospace"
```
크기 (1600×900 기준)
```
표지 대제목   120   제목(display)
슬라이드 제목  54   제목(display)
부제          30   본문
본문 불릿      26   본문
보조 설명      22   본문
캡션·라벨      18   숫자(mono), letter-spacing .08em
슬라이드 번호  20   숫자(mono)
```
- 한글 줄바꿈은 `<tspan x="110" dy="42">`로 수동 처리. `textLength` 쓰지 말 것.
- 본문 줄간격 42, 불릿 항목 간 간격 64.

## 3. 고정 레이아웃 (전 장 동일)
```
안전 여백      좌 110 / 우 110 (우측 끝 x=1490) / 상 90 / 하 110
슬라이드 번호  x=110  y=104   mono 20  fill=ink3   내용: "01" ~ "11"
요건 라벨      우상단. x=1490 text-anchor="end" y=104  mono 18 fill=ink3
              테두리 박스: stroke=line, fill=none, rx=3, 높이 34, 좌우 padding 14
슬라이드 제목  x=110  y=232 (baseline)  display 54  fill=ink
제목 밑 괘선   x1=110 y1=272 x2=1490 y2=272  stroke=line stroke-width="1"
본문 시작      y=346
```
### 하단 진행 틱 (전 장 필수)
틱 12개. i = 0..11, `x = 110 + i*18`, 두께 2, 하단 정렬 y2=838
- 비활성: `y1=828` stroke=line
- **활성 1개**: `y1=812` stroke=accent stroke-width="3"
- 활성 인덱스 = 슬라이드 번호 - 1 (01번→i=0, 11번→i=10). 12번째 틱은 항상 비활성.

우측 하단 러닝 캡션: `x=1490 y=838 text-anchor="end"` mono 16 fill=ink3
내용: `아타카 ATTACCA`

## 4. 슬라이드별 내용

### 01 표지  [담당 c0]
거의 빈 화면. 중앙 정렬 대신 좌측 정렬 권장.
- 대제목 `아타카` (display 120)
- 그 아래 `ATTACCA` (mono 28, letter-spacing .3em, fill=ink3)
- 그 아래 `"멈추지 말고, 이어서"` (display 40)
- 하단 부제 `파킨슨 보행 동결을 감지해, 그 순간의 보폭에 맞춘 리듬을 들려주는 웨어러블` (본문 26, ink2)
- 최하단 `이종하 · 단국대학교 뉴뮤직과 / 컴퓨터공학 · 2026.09.27` (mono 18, ink3)
- 제목 괘선·요건 라벨 없음. 슬라이드 번호도 생략. 진행 틱은 넣되 i=0 활성.

### 02 걷다가, 발이 바닥에 붙는다  [담당 c0]  라벨 〈주제〉
**3컷 실루엣 + 지면선 하나로 관통.** 세로 구분선·박스·프레임 전부 금지.
- 지면선: x=140 → x=1180, y=620, stroke=ink, 2px. **이 선 하나가 3컷을 관통**
- 실루엣 3개: 머리(원)+몸통+팔다리를 단색 ink로. 외곽선 없음
  - 1컷 (x≈250) 정상 보행 자세
  - 2컷 (x≈580) 두 발이 나란히 멈춤, 상체 직립
  - 3컷 (x≈900) **발 위치가 2컷과 정확히 동일**, 상체만 앞으로 기울어짐
  - ※ 발이 조금이라도 움직이면 "그냥 넘어지는 사람"이 됨. 이 그림의 전부가 이것
- 발자국: 지면선 위 작은 타원. 1컷 구간은 규칙적으로 5~6개, 2컷에서 두 발 나란히, **3컷 뒤로는 없음**
- 3컷 기울기 호: 점선, stroke=line (오커 금지)
- 캡션 (지면선 아래 y≈665, mono 18, ink3): `정상 보행` / `발이 안 떨어진다` / `상체만 앞으로`
- 우측 (x 1220~1490)에 악순환 4단계를 세로로: `동결 → 낙상 → 활동량 감소 → 보행 능력 저하` 그리고 맨 아래에서 맨 위로 돌아가는 화살표
- 좌상단 본문 1줄: `머리는 가려는데 다리가 안 나간다. 문턱·좁은 통로·방향 전환에서 특히 자주 발생한다.`
- 숫자 자리표시: `국내 환자 수 [    ] · 동결 경험 비율 [    ]` (mono 18, ink3, 점선 테두리 박스)

### 03 이미 알려진 해법이 있다  [담당 c0]  라벨 〈주제 선정 이유〉
- 제목 아래 부제: `리듬 청각 자극 (RAS, Rhythmic Auditory Stimulation)`
- 본문 3줄
  - `규칙적인 박자를 들려주면 얼어붙은 다리가 풀린다.`
  - `민간요법이 아니라 신경학적 음악치료(NMT)의 정식 기법이고, 임상 근거가 있다.`
  - `기저핵을 우회하는 경로로 설명된다.`  ← "우회한다" 단정형 금지
- 중앙 도해: 메트로놈 실루엣(추가 기울어진 형태) + 오른쪽으로 박자에 맞춰 규칙적으로 찍히는 발자국. **오커 금지, 전부 무채색**
- 하단 인용 블록 (좌측 2px 세로선 + 들여쓰기): `"저는 음악과 학생입니다. 이 지점이 제가 이 주제를 고른 이유입니다."` (display 32, ink)
- 각주 자리: `RAS 근거 문헌 [            ]` (mono 18, ink3, 점선 박스)

### 04 그런데 왜 안 쓰이나 — 습관화  [담당 b6]  **어두운 장**
- 부제: `지금 방식 — 메트로놈은 계속 울린다`
- 상단 레인 (y 360~430) `자극`: **완벽히 균일한 간격**의 세로 틱 약 56개를 x=260~1420에 배치. 전부 같은 높이, stroke=ink3(#5E6873), 절대 오커 금지
- 하단 레인 (y 470~600) `주의`: 지수 감쇠 곡선. 좌측 높게 시작해 금방 바닥에 붙어 끝까지 평평. 곡선 아래 아주 옅은 채움 가능
- 시간축 (y=640): 0분 / 5분 / 10분 / 15분 / 20분 눈금, mono 18 ink3
- 축 아래 y≈680 **속 빈 원** 3개 (r=11, stroke=ink2, fill=none) — 동결 시점. **x 좌표를 반드시 기록해 05번과 일치시킬 것: x = 420, 760, 1180**
- 세 번째 원에만 주석선 + 텍스트: `소리는 울리고 있다. 다만 들리지 않는다.`
- 우하단 보조 1줄 (22px, ink2): `기존 제품도 대부분 상시 큐이거나 수동 온/오프다 — 레이저 큐 신발, 웨어러블 큐잉 기기, 메트로놈 앱`

### 05 침묵하는 메트로놈  [담당 b6]  **어두운 장 · 오커 등장**  라벨 〈주제〉
**04를 복제해 지운 형태.** 축·눈금·레인 위치·동결 마커 x좌표(420·760·1180)가 04와 픽셀 단위로 동일해야 함.
- 부제: `제안 — 필요한 순간에만 울린다`
- 상단 `자극` 레인: 울타리 제거. **버스트 3개만** 남김. 각 버스트는 동결 마커 x 바로 위에 정렬
  - 버스트1 x≈420 중심, 틱 4개, **간격 넓게**
  - 버스트2 x≈760 중심, 틱 6개, **간격 가장 넓게**
  - 버스트3 x≈1180 중심, 틱 4개, **간격 좁게**
  - 색 #E3A83C, stroke-width 3
- 각 버스트 아래 mono 20 오커: `♩=96` / `♩=88` / `♩=104`  ← 이 한 끗이 "보폭에 맞춘 템포"를 설명 없이 증명
- 하단 `주의` 레인: 높은 위치에서 평평하게 유지, 버스트마다 작은 봉우리
- 최하단 침묵 표시: **얇은 양끝 화살표 선 하나**(stroke=ink3, 1px) + 중앙 텍스트 `이 구간 전체, 아무 소리도 나지 않음`. **회색 박스로 칠하지 말 것**
- 우상단 작게: `동결이 시작된 직후 → 개입 → 해제되면 다시 침묵`

### 06 어떻게 감지하나  [담당 12]
- 부제: `얼어붙을 때 다리에 잔떨림이 생긴다`
- 좌우 2단 스펙트럼 그래프 (각 폭 약 600)
  - 좌: `정상 보행` — 0.5~3 Hz 구간에 큰 봉우리
  - 우: `동결` — 3~8 Hz 구간에 봉우리 이동
  - x축 라벨 mono 18: `0.5` `3` `8` (Hz)
  - 두 그래프 사이에 나눗셈 기호 또는 화살표
- 중앙 하단 수식 대신 문장 (26px): `Freeze Index = 3~8 Hz 대역의 세기 ÷ 0.5~3 Hz 대역의 세기`
- 본문 2줄
  - `이 비율이 임계값을 넘고, 일정 시간 유지될 때만 동결로 판정한다.`
  - `임계 하나로 확정하지 않는 이유는 계단·방향 전환 같은 정상 동작의 오탐을 막기 위해서다.`
- 하단 주의 박스 (점선 테두리, ink3): `Freeze Index는 예측이 아니라 검출 지표다. 따라서 "동결이 시작된 직후"에 개입한다.`
- 우하단 확장 1줄 (22px ink3): `확장 — SR04 초음파로 문턱·좁은 통로 접근을 미리 감지하면 사전 대비가 가능하다`
- **전부 무채색**

### 07 시스템 구성  [담당 12]  라벨 〈수업에 활용된 기능〉
- 좌측 (x 110~560): 허리에 벨트를 찬 사람 실루엣. 작게, ink 단색. 벨트 위치에 작은 사각형 + `허리 벨트 단일 유닛` 캡션
- 중앙~우측: 블록 다이어그램. 박스는 stroke=line fill=none rx=3, 화살표는 ink2
  - `MPU-6050` --I2C--> `ESP32` --PWM--> `수동 부저`
  - `ESP32` --I2C--> `OLED` / `택트스위치` --GPIO--> `ESP32`
  - 점선 박스로 확장: `WiFi` `심박센서`
- 하단 표 3열 (괘선만, 세로선 없음). 헤더 mono 18 ink3: `구분` `수업에서 배운 기능` `이 프로젝트에서의 역할`
  - `핵심` / I2C 통신 / MPU-6050 가속도 읽기
  - `핵심` / PWM 출력 / 수동 부저 톤 생성 — 능동이 아닌 수동 부저를 쓰는 이유는 음정 제어
  - `보조` / I2C 통신 / OLED 기록 화면
  - `보조` / GPIO 입력 / 택트스위치 — 감지 실패 시 수동 요청
  - `확장` / WiFi · ADC / 기록 전송, 정지 구간 심박
- 좌하단 한 줄 (22px ink2): `KIT 부품을 전부 필수인 척 나열하지 않는다. 핵심 2 · 보조 2 · 확장 2의 구조를 그대로 드러낸다.`

### 08 페르소나와 대상  [담당 e6]  **오커 등장**  라벨 〈페르소나〉〈대상〉
### 09 구현 계획  [담당 e6]
### 10 한계와 대응  [담당 e6]

### 11 마무리  [담당 b6]  **오커 등장**
- 01번 표지를 거의 그대로 재현하되 더 비움
- `아타카` (display 96) / `멈추지 말고, 이어서` (display 40)
- 하단 인용 (display 30, ink): `"치료법은 이미 있었습니다. 저는 그걸 언제 꺼낼지를 정해보려 합니다."`
- 오커 사용처: `아타카` 아래 짧은 밑줄 1개, 또는 틱 3개. 최소한으로
- 요건 라벨 없음

## 5. 제출
- 파일: `/Users/jongha/Desktop/디바이스/ppt/NN.svg`
- 완료하면 claude-e6에게 SendMessage로 보고. 파일명과 특이사항만.
- 규격에서 벗어난 판단을 했으면 반드시 그 이유를 함께 보고할 것.
