bell-ha/fog-cue/2_중간발표/자료/걷기_동결흉내_비교.png

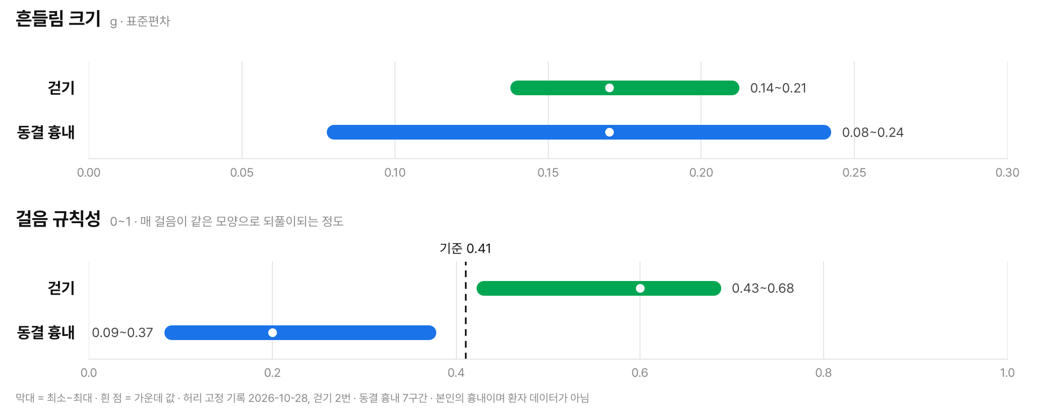
2_중간발표/자료/걷기_동결흉내_비교.png
