bell-ha/fog-cue/2_중간발표/자료/기능시험_걷는중.png

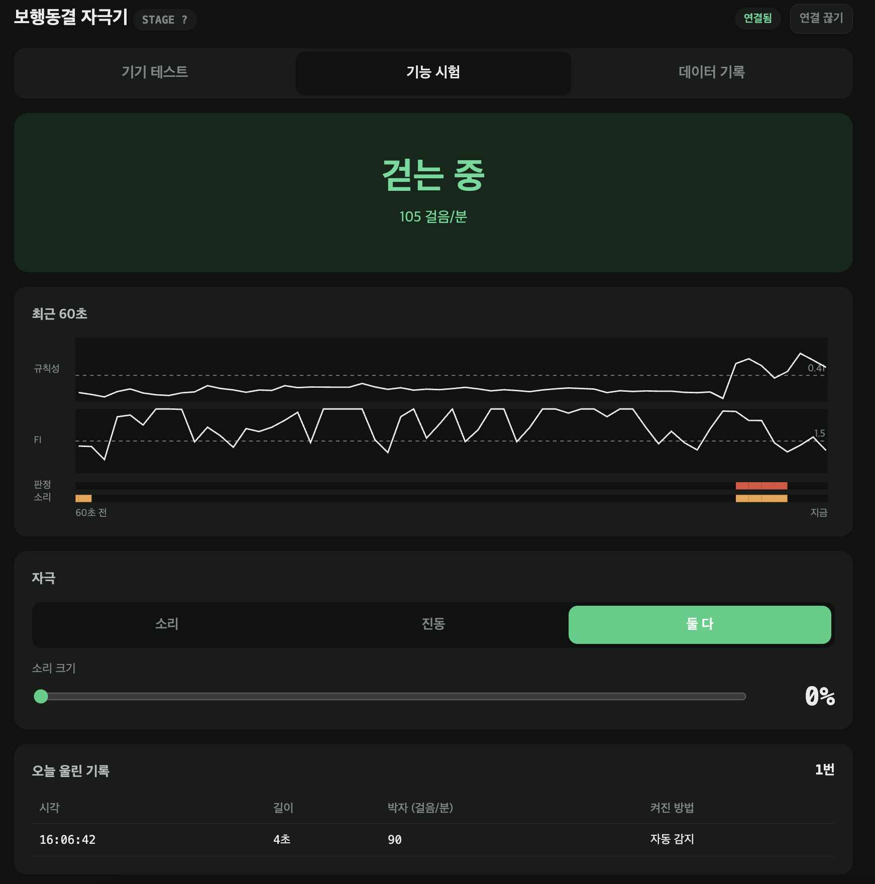
2_중간발표/자료/기능시험_걷는중.png
