bell-ha/fog-cue/2_중간발표/자료/기록화면_서있기.png

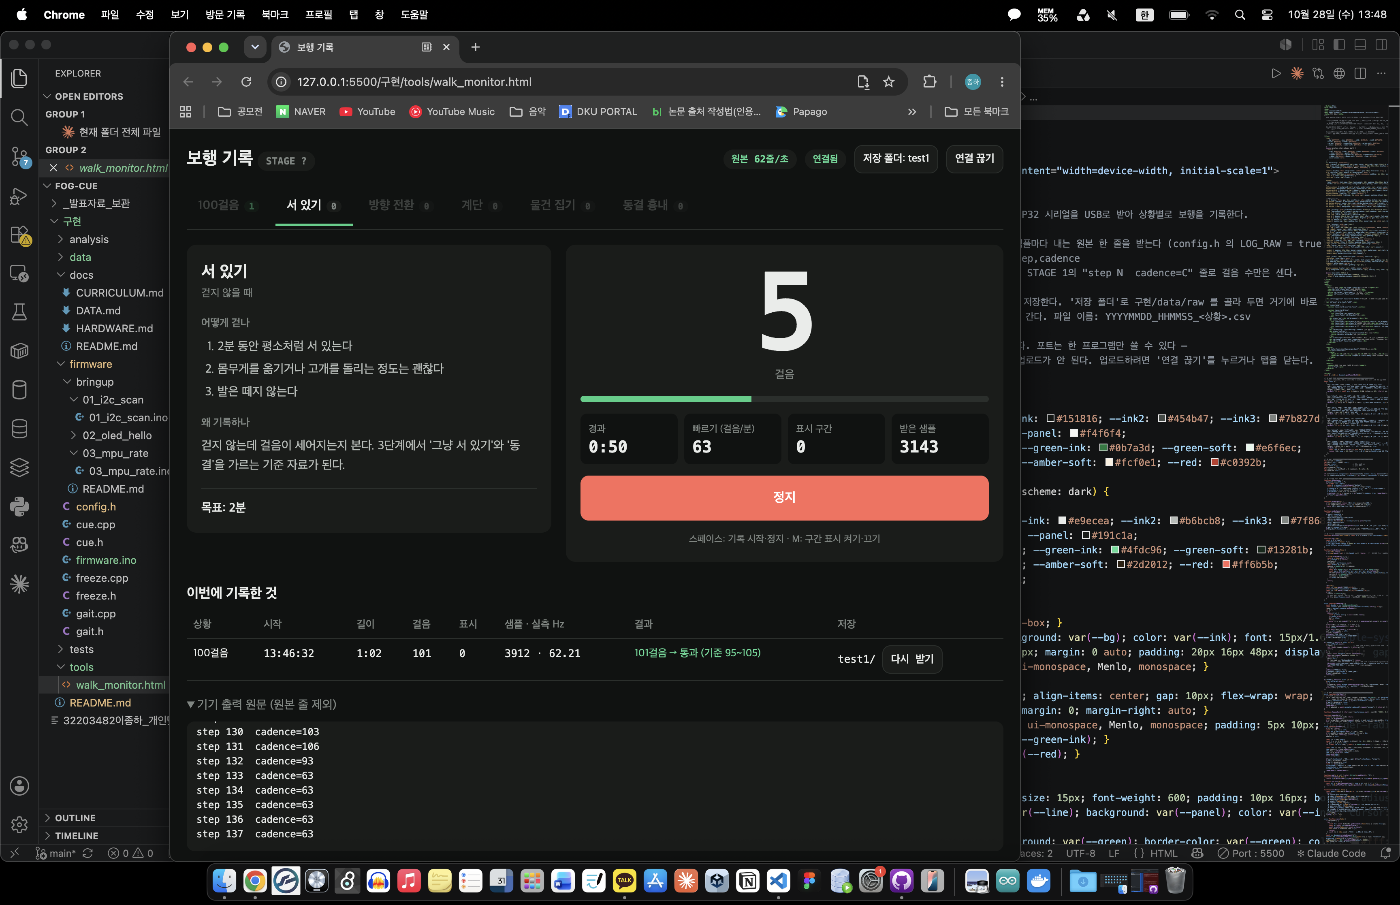
2_중간발표/자료/기록화면_서있기.png
