bell-ha/fog-cue/2_중간발표/자료/센서_샘플레이트_시험.png

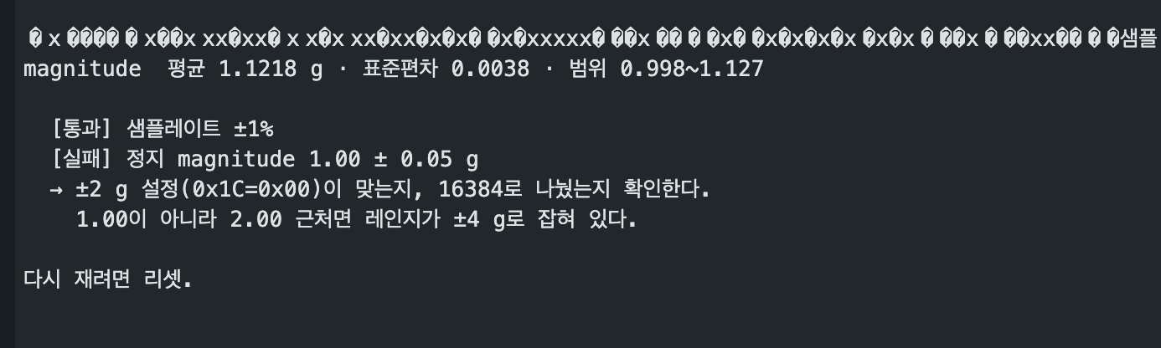
2_중간발표/자료/센서_샘플레이트_시험.png
