bell-ha/fog-cue/2_중간발표/자료/스크린샷 2026-10-28 16.06.37.png

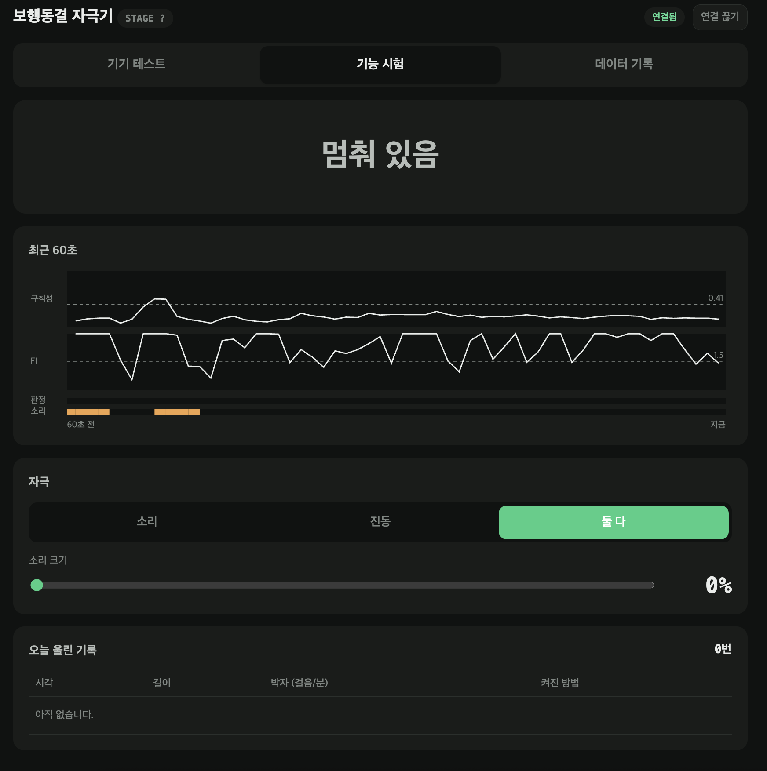
2_중간발표/자료/스크린샷 2026-10-28 16.06.37.png
