bell-ha/fog-cue/_발표자료_보관/원본사진/KakaoTalk_Photo_2026-09-15-17-43-19 003.jpeg

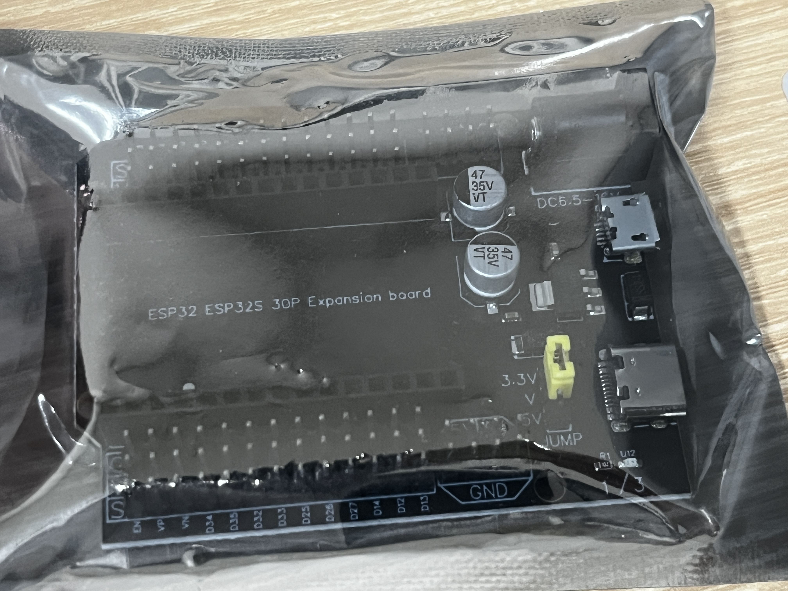
_발표자료_보관/원본사진/KakaoTalk_Photo_2026-09-15-17-43-19 003.jpeg
