bell-ha/fog-cue/_발표자료_보관/원본사진/KakaoTalk_Photo_2026-09-15-22-47-57.jpeg

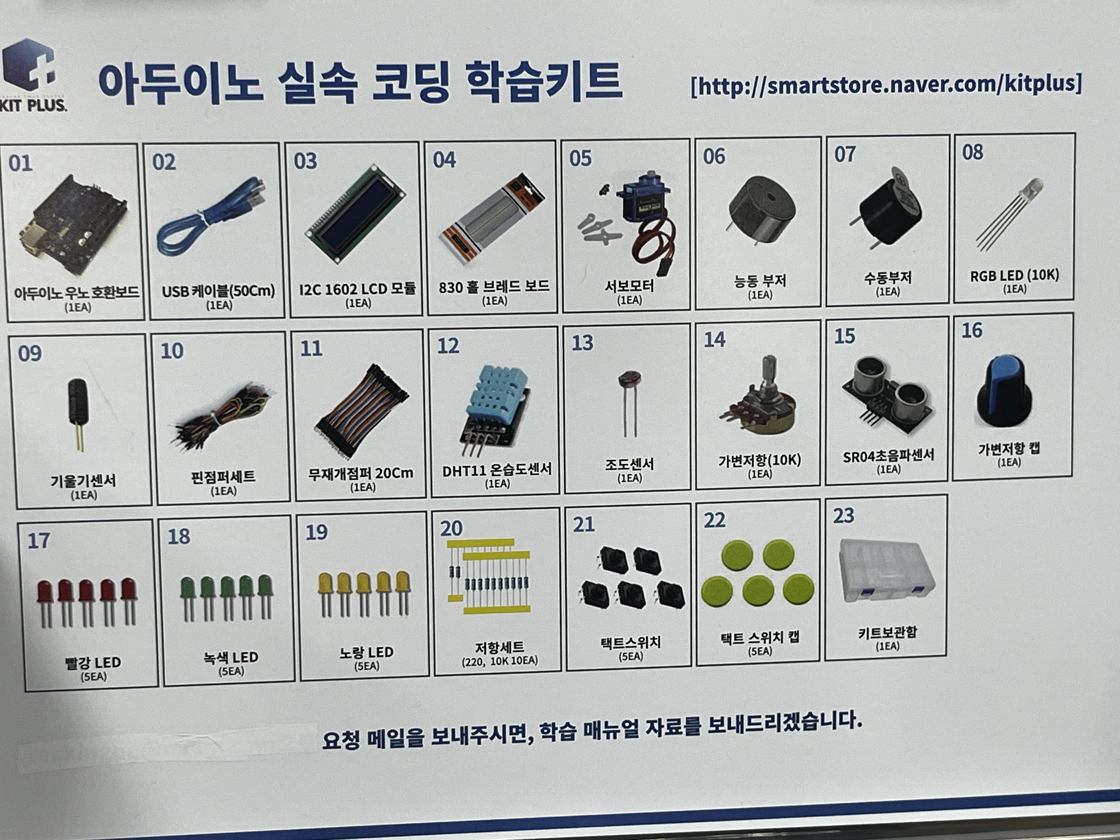
_발표자료_보관/원본사진/KakaoTalk_Photo_2026-09-15-22-47-57.jpeg
