bell-ha/fog-cue/1_아이디어발표/parts/buzzer_passive.png

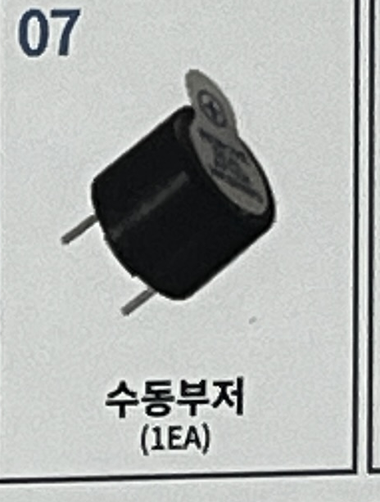
1_아이디어발표/parts/buzzer_passive.png
