bell-ha/fog-cue/_발표자료_보관/parts/esp32.png

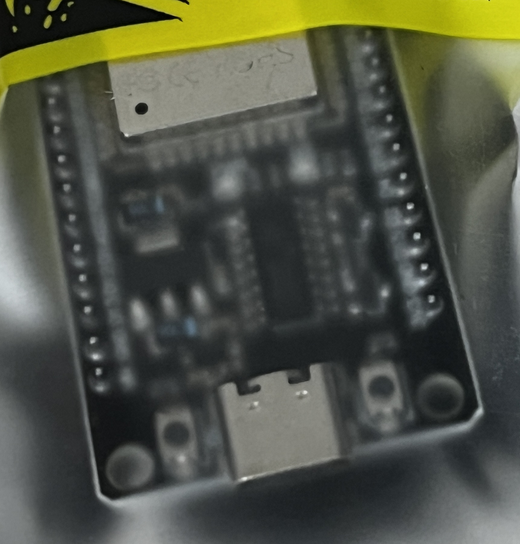
_발표자료_보관/parts/esp32.png
