bell-ha/fog-cue/_발표자료_보관/parts/expboard.png

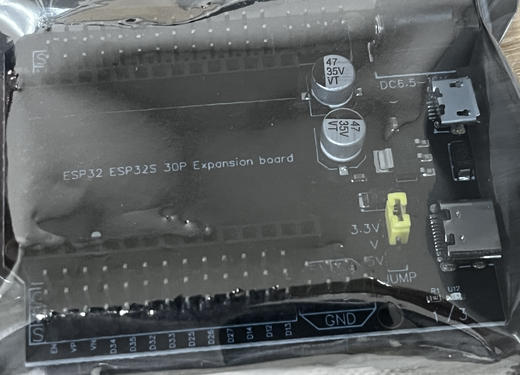
_발표자료_보관/parts/expboard.png
