bell-ha/fog-cue/_발표자료_보관/parts/mpu6050.png

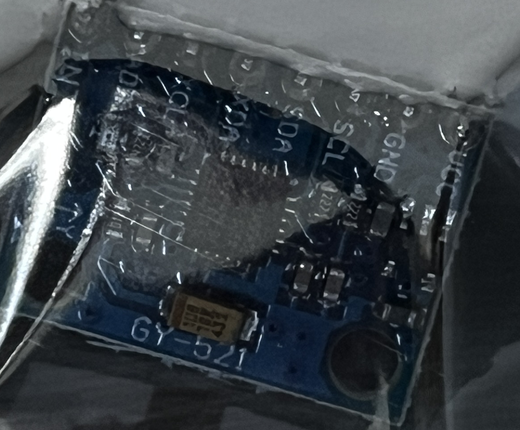
_발표자료_보관/parts/mpu6050.png
