bell-ha/fog-cue/0_구현/firmware/firmware.ino

// firmware.ino — 보행동결 자극 시스템
//
//   걷다가 발이 굳는 순간에만 박자를 들려주는 허리 벨트
//
// 상태 흐름
//   WALKING  걷는 중. 조용하다. 걸음 간격으로 케이던스를 계속 갱신한다
//   STOPPED  걸음이 끊겼다 (2단계 최소 목표는 여기서 바로 울린다)
//   FROZEN   동결 판정이 연속으로 나왔다. 자극을 준다 (3단계)
//            판정 = 움직임이 있고, 걸음 리듬이 무너졌거나 떨림이 강하다. config.h 참조
//   2단계는 걸음이 다시 잡히면, 3단계는 판정이 연속으로 풀리면 WALKING으로 돌아가고 소리가 멎는다
//
// 빌드 단계를 STAGE로 고른다. 발표 9번의 4단계와 같다.
//   STAGE 1  걸음만 센다 (시리얼로 확인)
//   STAGE 2  멈추면 울린다              ← 최소 목표
//   STAGE 3  동결만 골라낸다 (걸음 규칙성 + Freeze Index) · 택트스위치로 직접 켜고 끄기
//            몸이 도는 동안은 판정을 미룬다 (자이로, src/turn.h)
//   STAGE 4  부가 기능
//   Wi-Fi는 단계와 상관없이 firmware/wifi_secret.h가 있으면 켜진다 (src/link.h)
#define STAGE 3

#include <Wire.h>
#include <Preferences.h>
#include "config.h"
#include "src/gait.h"
#include "src/freeze.h"
#include "src/cue.h"
#include "src/turn.h"
#include "src/link.h"

constexpr uint8_t MPU_ADDR = 0x68;

GaitTracker     gait;
FreezeDetector  freeze;
CuePlayer       cue;
TurnTracker     turn;

enum State { WALKING, STOPPED, FROZEN };
// 박자가 꺼진 이유 — 앱 화면용 e 줄에 실린다 (아래 '상태 전환' 참조)
enum StopReason { STOP_RELEASED = 0, STOP_BUTTON = 1, STOP_TIMEOUT = 2, STOP_WEB = 3 };
State state = WALKING;

// 샘플 주기는 MPU가 정한다(아래 loop의 DATA_RDY 참조). 여기서 타이머를 돌리지 않는다.
// SAMPLE_HZ는 '언제 읽을지'가 아니라 '대역 경계를 어디로 둘지' 계산에만 쓰인다.

// ─── MPU-6050 ────────────────────────────────────────
void mpuWrite(uint8_t reg, uint8_t val) {
  Wire.beginTransmission(MPU_ADDR);
  Wire.write(reg); Wire.write(val);
  Wire.endTransmission();
}

void mpuBegin() {
  // 절전 해제를 빼먹으면 MPU는 자고 있고 값이 전부 0이다. 가장 흔한 첫 실수다.
  // 클럭은 자이로 X축 PLL — 내부 RC 발진기(±1%)보다 정확하다. 자이로를 켜야 쓸 수 있다
  mpuWrite(0x6B, 0x01);
  delay(100);
  // 순서 주의 — DLPF를 먼저 켜야 내부 출력이 1 kHz가 되고, 그 다음에야
  // SMPLRT_DIV가 1000/(1+DIV)로 동작한다. 반대로 하면 분주 기준이 8 kHz다.
  mpuWrite(0x1A, MPU_DLPF_CFG);     // DLPF ≈21 Hz. 샘플링 62.5 Hz의 나이퀴스트(31.25) 아래
  mpuWrite(0x19, MPU_SMPLRT_DIV);   // 1000/(1+15) = 62.5 Hz
  mpuWrite(0x1C, 0x00);   // 가속도 ±2 g. 보행 가속도는 대부분 여기 들어온다
  // 자이로 ±500 °/s. 돌아서는 것을 가려낼 때 쓴다 (src/turn.h). 전류는 약 3.6 mA 더 든다
  mpuWrite(0x1B, 0x08);
  mpuWrite(0x6C, 0x00);   // 모든 축 켜기
}

// 가속도 3축(g)과 자이로 3축(°/s). 중력 성분은 뒤에서 각 모듈이 알아서 뺀다
// 크기만이 아니라 3축을 돌려주는 이유 — LOG_RAW로 원본을 남겨야 나중에 PC에서 다시 분석할 수 있다
// 레지스터 0x3B부터 14바이트: 가속도 6 · 온도 2 · 자이로 6
bool readImu(float* a, float* g) {
  Wire.beginTransmission(MPU_ADDR);
  Wire.write(0x3B);
  Wire.endTransmission(false);
  Wire.requestFrom((int)MPU_ADDR, 14, true);
  if (Wire.available() < 14) return false;
  int16_t v[7];
  for (int i = 0; i < 7; i++) v[i] = (Wire.read() << 8) | Wire.read();
  const float LSB = 16384.0f;   // ±2 g
  for (int k = 0; k < 3; k++) { a[k] = v[k] / LSB; g[k] = v[4 + k] / GYRO_LSB; }
  return true;
}

// ─── 기록 ────────────────────────────────────────────
struct Event { uint32_t t_ms; int tempo; uint8_t manual; };
Event  events[MAX_EVENTS];
int    n_events = 0;

void logEvent(uint32_t t, int tempo, bool manual) {
  if (n_events >= MAX_EVENTS) {           // 넘치면 오래된 것부터 버린다
    for (int i = 0; i < MAX_EVENTS - 1; i++) events[i] = events[i + 1];
    n_events = MAX_EVENTS - 1;
  }
  events[n_events++] = { t, tempo, (uint8_t)manual };
}

// ─── 템포 기억 ───────────────────────────────────────
// 1초마다 케이던스를 적어 두고, 자극을 시작할 때 CUE_TEMPO_LOOKBACK_S초 전 값을 쓴다.
// 판정이 나올 무렵에는 떨림이 걸음으로 세어져 케이던스가 부풀어 있다 (config.h 참조).
int      cad_hist[CUE_TEMPO_LOOKBACK_S + 1] = {0};
uint32_t cad_hist_ms = 0;

void rememberCadence(uint32_t now) {
  if (now - cad_hist_ms < 1000) return;
  cad_hist_ms = now;
  for (int i = CUE_TEMPO_LOOKBACK_S; i > 0; i--) cad_hist[i] = cad_hist[i - 1];
  cad_hist[0] = gait.cadence();
}

int cadenceBeforeFreeze() { return cad_hist[CUE_TEMPO_LOOKBACK_S]; }

// 시험 소리가 끝날 시각. 0이면 시험 중이 아니다
uint32_t test_until_ms = 0;
// 자극을 낼지. 꺼 두면 판정과 버튼은 알리기만 하고 소리·진동은 내지 않는다.
// 웹 화면은 '기능 시험'에서 시작을 눌렀을 때만 켠다 — 기기 테스트나 기록 중에 흔들어서 울리지 않게.
// 기기를 다시 켜면 켜진 상태로 돌아온다 — 웹 없이 혼자 쓸 때는 바로 동작해야 한다
bool     cue_enabled = true;
// 시연 모드 (config.h) — 자동 판정을 쉬고, 버튼으로 굳음 · 풀림을 낸다
bool     demo_mode = false;

// 걷던 빠르기 — 5초 전 값을 쓰고, 모르면 지금 값
int demoTempo() { int c = cadenceBeforeFreeze(); return c ? c : gait.cadence(); }

// ─── 상태 전환 ───────────────────────────────────────
// 앱 화면용 줄 — 박자가 켜지고 꺼질 때 한 줄씩. 시험 소리·진동은 내지 않는다
//   e,<t_ms>,1,<템포>,<버튼이면 1>
//   e,<t_ms>,0,<꺼진 이유>        이유: 0 판정 풀림 · 1 버튼 · 2 30초 자동 정지 · 3 웹에서 끔
bool real_cue = false;    // 지금 나는 박자가 판정·버튼으로 켠 것인지 (시험이면 false)

void enterCue(uint32_t now, bool manual, int cadence_bpm) {
  // 시험 소리가 울리는 중에 진짜 판정이 나면 시험을 접고 판정 쪽 템포로 다시 시작한다
  if (test_until_ms) { cue.stop(); test_until_ms = 0; }
  cue.start(cadence_bpm, now);
  logEvent(now, cue.tempo(), manual);
  real_cue = true;
  out.printf("[CUE ] t=%lus tempo=%d%s\n",
                now / 1000, cue.tempo(), manual ? " (수동)" : "");
  out.printf("e,%lu,1,%d,%d\n", (unsigned long)now, cue.tempo(), manual ? 1 : 0);
}

void leaveCue(uint32_t now, StopReason why) {
  if (cue.active()) {
    cue.stop();
    out.printf("[STOP] t=%lus\n", now / 1000);
  }
  if (real_cue) {
    real_cue = false;
    out.printf("e,%lu,0,%d\n", (unsigned long)now, (int)why);
  }
}

// ─── 웹 화면에서 오는 명령 ───────────────────────────
//   v,<0~100>   소리 크기(%) (플래시에 남는다)
//   b[,bpm]     시험 소리 2마디(8박). bpm을 주면 그 템포로, 없으면 지금 케이던스(모르면 기본값)
//   z[,bpm]     시험 진동 2마디(8박). 템포는 b와 같다
//   y           진동 2초 계속 — 배선 확인용. 판정 상태와 상관없이 바로 낸다
//   m,<0|1|2>   자극 방식 — 0 소리 · 1 진동 · 2 둘 다 (플래시에 남는다)
//   a,<0|1>     자극 켜기·끄기. 0이면 판정·버튼은 알리기만 한다 (다시 켜면 1로 돌아온다)
//   s           지금 나는 소리를 끈다 (판정·버튼·시험 소리 모두)
//   d,<0|1>     시연 모드 — 버튼이 판정 대신 (config.h, 플래시에 남는다)
// 설정 저장 (ESP32 플래시 NVS). 값이 바뀔 때만 쓴다 — 웹이 연결할 때마다 같은 값을 다시 보내도 플래시를 닳게 하지 않게
Preferences prefs;
void saveSetting(const char* key, int v) {
  if (prefs.getInt(key, -1) != v) prefs.putInt(key, v);
}

const char* modeName(int m) { return m == CUE_SOUND ? "소리" : m == CUE_VIBE ? "진동" : "둘 다"; }

void handleCommand(const char* s, uint32_t now) {
  if (s[0] == 'v' && s[1] == ',') {
    cue.setVolume(atoi(s + 2));
    saveSetting("vol", cue.volume());
    out.printf("[VOL ] %d%%\n", cue.volume());
  } else if ((s[0] == 'b' || s[0] == 'z') && (s[1] == '\0' || s[1] == ',')) {
    // b = 시험 소리, z = 시험 진동. 설정된 방식과 상관없이 그것만 낸다
    if (state == FROZEN) { out.println("[TEST] 동결 판정 중이라 시험을 건너뛴다"); return; }
    int  bpm  = s[1] == ',' ? atoi(s + 2) : gait.cadence();   // 범위 밖이면 cue.start가 기본값으로 바꾼다
    bool vibe = s[0] == 'z';
    cue.stop();
    cue.start(bpm, now, vibe ? CUE_VIBE : CUE_SOUND);
    test_until_ms = now + 7 * (60000UL / cue.tempo()) + VIBE_DOWNBEAT_MS + 20;
    if (test_until_ms == 0) test_until_ms = 1;
    out.printf("[TEST] 시험 %s tempo=%d vol=%d%%\n", vibe ? "진동" : "소리", cue.tempo(), cue.volume());
  } else if (s[0] == 'y' && s[1] == '\0') {
    cue.vibrateFor(now, 2000);
    out.println("[TEST] 진동 2초");
  } else if (s[0] == 'm' && s[1] == ',') {
    cue.setMode(atoi(s + 2));
    saveSetting("mode", cue.mode());
    out.printf("[MODE] %s\n", modeName(cue.mode()));
  } else if (s[0] == 's' && s[1] == '\0') {
    test_until_ms = 0;
    leaveCue(now, STOP_WEB); // 동결 판정 중이면 상태는 남는다 — 판정이 풀리기 전에는 다시 켜지 않는다
    if (demo_mode) state = WALKING;   // 시연 모드는 버튼이 판정이라, 끄면 풀린 것으로 본다
  } else if (s[0] == 'd' && s[1] == ',') {
    bool on = s[2] != '0';
    if (on != demo_mode && state == FROZEN) { leaveCue(now, STOP_RELEASED); state = WALKING; }
    if (on != demo_mode) freeze.reset();   // 판정을 처음부터 — 쉬는 동안 쌓인 값으로 바로 울리지 않게
    demo_mode = on;
    saveSetting("demo", demo_mode ? 1 : 0);
    out.printf("[DEMO] 시연 모드 %s\n", demo_mode ? "켬" : "끔");
  } else if (s[0] == 'a' && s[1] == ',') {
    cue_enabled = s[2] != '0';
    if (!cue_enabled) { test_until_ms = 0; leaveCue(now, STOP_WEB); }
    out.printf("[ARM ] 자극 %s\n", cue_enabled ? "켬" : "끔");
  }
}

void pollCommands(uint32_t now) {
  static char line[24];
  static int  n = 0;
  while (Serial.available()) {
    char c = (char)Serial.read();
    if (c == '\n' || c == '\r') {
      if (n) { line[n] = '\0'; handleCommand(line, now); n = 0; }
    } else if (n < (int)sizeof(line) - 1) {
      line[n++] = c;
    }
  }
  // Wi-Fi로 온 명령도 같은 길로
  char wl[24];
  while (wlink::readCommand(wl, sizeof(wl))) handleCommand(wl, now);
  if (test_until_ms && (int32_t)(now - test_until_ms) >= 0) {
    cue.stop();
    test_until_ms = 0;
    out.println("[TEST] 끝");
  }
}

// ─── setup / loop ────────────────────────────────────
void setup() {
  Serial.begin(115200);
  delay(200);
  Wire.begin(PIN_SDA, PIN_SCL, 400000);
  pinMode(PIN_BUTTON, INPUT_PULLUP);

  mpuBegin();
  gait.begin();
  freeze.begin();
  turn.begin();
  cue.begin();
  // 소리 크기 · 박자 방식은 플래시에 남는다 — 외출 전에 '진동'으로 바꿔 두면 껐다 켜도 그대로다
  prefs.begin("fogcue", false);
  cue.setVolume(prefs.getInt("vol", CUE_VOLUME_DEFAULT));
  cue.setMode(prefs.getInt("mode", CUE_MODE_DEFAULT));
  demo_mode = prefs.getInt("demo", 0) == 1;
  wlink::begin();

  out.printf("보행동결 자극 시스템 · STAGE %d · %.1f Hz\n", STAGE, SAMPLE_HZ);
  out.printf("[VOL ] %d%%\n", cue.volume());
  out.printf("[MODE] %s\n", modeName(cue.mode()));
  out.printf("[DEMO] 시연 모드 %s\n", demo_mode ? "켬" : "끔");
  // W2에서 이 값을 실측으로 확인할 것 — 1분간 샘플 수 ÷ 60 이 62.5 ± 1% 여야 한다.
}

// 새 샘플이 준비됐는지 MPU에게 묻는다. INT_STATUS(0x3A) bit0 = DATA_RDY.
bool mpuReady() {
  Wire.beginTransmission(MPU_ADDR);
  Wire.write(0x3A);
  Wire.endTransmission(false);
  Wire.requestFrom((int)MPU_ADDR, 1, true);
  return Wire.available() && (Wire.read() & 0x01);
}

void loop() {
  // ★ 고정 주기로 읽지 않고 MPU가 '준비됐다'고 할 때만 읽는다.
  //
  // MPU는 자이로를 끄면 내부 RC 발진기로 도는데 오차가 ±1% 쯤 된다.
  // ESP32는 수정 발진기라 훨씬 정확하다. 고정 주기로 읽으면 둘이 서서히 어긋나
  // **같은 샘플을 두 번 읽거나 한 샘플을 건너뛴다.** 1% 차이면 약 1.6초마다 한 번씩이다.
  // FFT는 '일정 간격으로 찍힌 샘플'을 전제하므로 이게 그대로 오차가 된다.
  //
  // DATA_RDY를 보면 샘플 하나당 정확히 한 번 읽는다. 대신 루프가 MPU 속도에 끌려가는데,
  // 그게 맞다 — **대역 경계 계산에 들어가야 할 fs는 ESP32가 정한 값이 아니라 MPU가 내는 값**이다.
  // tools/bringup/03_mpu_rate 로 그 값을 재서 config.h 의 SAMPLE_HZ 에 넣는다.
  pollCommands(millis());   // 웹 화면의 소리 크기·시험 소리. 샘플을 기다리는 동안에도 받는다
  if (!mpuReady()) return;
  uint32_t now = millis();

  float a[3], g[3];
  // 읽기에 실패한 샘플은 버린다. 0을 넣으면 1 g짜리 가짜 충격이 걸음·동결 판정에 들어간다
  if (!readImu(a, g)) return;
  const float ax = a[0], ay = a[1], az = a[2];
  float mag  = sqrtf(ax * ax + ay * ay + az * az);
  bool  step = gait.update(mag, now);
  turn.update(ax, ay, az, g[0], g[1], g[2], now);

  // 마지막 열 = 세로축 회전 빠르기 °/s
  if (LOG_RAW)
    out.printf("r,%lu,%.4f,%.4f,%.4f,%d,%d,%.1f\n",
                  (unsigned long)now, ax, ay, az, step ? 1 : 0, gait.cadence(), turn.yawRate());

#if STAGE >= 3
  bool judged = freeze.push(mag, turn.holdOff(now));
  rememberCadence(now);
#endif

#if STAGE == 1
  // ── 1단계: 걸음만 센다 ──
  static uint32_t count = 0;
  if (step) out.printf("step %lu  cadence=%d\n", ++count, gait.cadence());

#elif STAGE == 2
  // ── 2단계: 멈추면 울린다. 동결인지 아닌지는 아직 안 가린다 ──
  if (state == WALKING && gait.stopped(now)) {
    state = STOPPED;
    enterCue(now, false, gait.cadence());
  }
  if (state != WALKING && step) { leaveCue(now, STOP_RELEASED); state = WALKING; }

#else
  // ── 3단계 이상: 판정기만 본다 ──
  // 걸음은 보지 않는다. 떠는 동안에도 몸이 들썩여 걸음이 계속 세어지기 때문이다
  // (10/28 기록: 떨기 중 걸음이 끊긴 최장 시간 0.7~2.1초). 예전 구조처럼
  // '걸음이 2초 끊기면(STOPPED) 그때 FI를 본다'로 하면 그 기록들에서 한 번도 울리지 않았다.
  //
  // 소리가 안전장치(CUE_MAX_MS)로 멈춰도 상태는 FROZEN에 남는다.
  // 판정이 풀리기 전에는 다시 켜지 않는다 — 계속 울리는 기기가 되지 않게.
  if (judged) {
    if (demo_mode) {
      // 시연 모드: 자동 판정은 쉰다. 상태는 버튼이 바꾼다 (아래)
    } else if (state != FROZEN && freeze.isFrozen()) {
      state = FROZEN;                  // 자극이 꺼져 있어도 상태는 바뀐다 — 판정 줄로 웹이 본다
      if (cue_enabled) enterCue(now, false, cadenceBeforeFreeze());
    } else if (state == FROZEN && !freeze.isFrozen()) {
      leaveCue(now, STOP_RELEASED);
      state = WALKING;
    }
    if (LOG_RAW)
      // 마지막 열 = 도는 중이라 판정을 미루고 있는가
      out.printf("f,%lu,%.3f,%.3f,%.5f,%d,%d,%d,%d\n", (unsigned long)now,
                    freeze.freezeIndex(), freeze.regularity(), freeze.lastPower(),
                    demo_mode ? (state == FROZEN) : freeze.candidate(),
                    demo_mode ? (state == FROZEN) : freeze.isFrozen(), cue.active() ? 1 : 0,
                    (!demo_mode && turn.holdOff(now)) ? 1 : 0);
  }
#endif

#if STAGE >= 3
  // 검출이 빗나갔을 때 사용자가 직접 요청하는 경로 — 누를 때마다 소리를 켜고 끈다.
  // 판정이 못 잡는 '완전히 굳는 동결'과, 걷기가 아닌 움직임에서 잘못 울린 소리를 사람이 바로잡는다.
  // 3단계부터 켠다 — 판정을 시험하는 동안에도 잘못 울린 소리를 끌 수 있어야 한다
  //
  // 접점은 누르고 뗄 때 잠깐 튄다. 같은 값이 3샘플(약 48 ms) 이어져야 바뀐 것으로 본다
  static bool    raw_prev = HIGH, stable = HIGH;
  static uint8_t same = 0;
  bool raw = digitalRead(PIN_BUTTON);
  same = (raw == raw_prev) ? (same < 3 ? same + 1 : same) : 0;
  raw_prev = raw;
  if (same >= 2 && raw != stable) {
    stable = raw;
    out.println(stable == LOW ? "[BTN ] 누름" : "[BTN ] 뗌");
    if (stable == LOW && cue_enabled) {
      if (demo_mode) {
        // 시연 모드: 버튼 = 판정. 누르면 굳음, 다시 누르면 풀림
        if (state == FROZEN) { leaveCue(now, STOP_RELEASED); state = WALKING; }
        else { state = FROZEN; enterCue(now, false, demoTempo()); }
      } else {
        if (cue.active()) leaveCue(now, STOP_BUTTON); else enterCue(now, true, cadenceBeforeFreeze());
      }
    }
  }
#endif

  cue.update(now);
  // 안전장치(CUE_MAX_MS)는 cue 안에서 조용히 멈춘다. 앱 화면에는 30초 자동 정지로 알린다
  if (real_cue && !cue.active()) {
    real_cue = false;
    out.printf("e,%lu,0,%d\n", (unsigned long)now, (int)STOP_TIMEOUT);
  }
}
