bell-ha/fog-cue/(commit log)

2026-10-28 보행동결 중간구현
    mcu, 부저, 버튼, 진동까지 추가하였음
2026-10-28 중간발표준비
2026-11-08 중간피드백발표진행중
2026-11-09 Wi-Fi 연결 · 앱 화면 · 설정 기억 · 돌아서기 구분, 중간피드백발표 자료
2026-11-09 보행동결탐지완료
