bell-ha/fog-cue/2_중간발표/자료/회로_실물.jpg

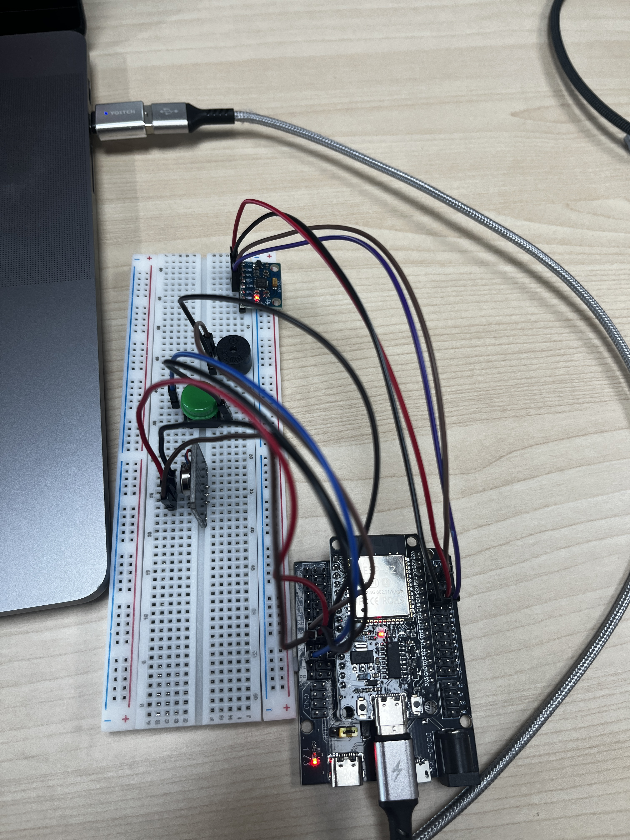
2_중간발표/자료/회로_실물.jpg
